troisiemetype/ccboard/Docs/155x32x111 enclosure.jpg

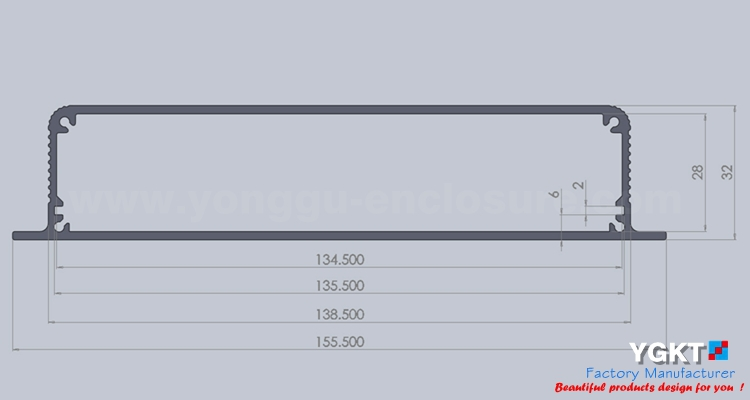
Docs/155x32x111 enclosure.jpg
