troisiemetype/ccboard/Components/BOM.ods

Sheet: ContactConsequencesMono
Id | Designator | Package | Quantity | Designation | Supplier and ref
3 | C1,C5,C8,C9,C10,C11,C12,C15,C16,C17,C18,C22,C23,C24,C25,C31,C32,C33,C38,C39,C41,C43,C50,C51,C52,C53,C6,C47 | C_0603 | 28 | 100n
7 | C13,C14 | C_0603 | 2 | 33p
8 | C19,C26,C34,C49 | CP_Tantalum_Case-A_EIA-3216-18_Reflow | 4 | 10u±
4 | C2,C3 | C_0603 | 2 | 22p
9 | C20,C21,C42,C45,C48 | C_0603 | 5 | 10n
10 | C27,C28 | C_0603 | 2 | 470n
5 | C4,C46 | C_0603 | 2 | 10u
11 | C40,C44 | C_0603 | 2 | 4,7u
6 | C7,C29,C30,C35,C36,C37 | C_0603 | 6 | 1u
12 | D1 | D_1206 | 1 | D
21 | D10 | LED_0603 | 1 | VU_05
22 | D11 | LED_0603 | 1 | VU_06
23 | D12 | LED_0603 | 1 | VU_07
24 | D13 | LED_0603 | 1 | VU_08
25 | D14 | LED_0603 | 1 | VU_09
26 | D15 | LED_0603 | 1 | VU_10
27 | D16 | LED_0603 | 1 | VU_11
28 | D17 | LED_0603 | 1 | VU_12
29 | D18 | LED_0603 | 1 | VU_13
30 | D19 | LED_0603 | 1 | VU_14
13 | D2 | LED_0603 | 1 | LED
31 | D20 | LED_0603 | 1 | VU_15
32 | D21 | LED_0603 | 1 | VU_16
33 | D22 | LED_0603 | 1 | VU_17
34 | D23 | LED_0603 | 1 | VU_18
35 | D24 | LED_0603 | 1 | VU_19
36 | D25 | LED_0603 | 1 | VU_20
37 | D26 | LED_0603 | 1 | VU_21
38 | D27 | LED_0603 | 1 | VU_22
39 | D28 | LED_0603 | 1 | VU_23
40 | D29 | LED_0603 | 1 | VU_24
14 | D3 | D_SOD-123 | 1 | D_Schottky
41 | D30 | LED_0603 | 1 | VU_25
42 | D31 | LED_0603 | 1 | VU_26
43 | D32 | LED_0603 | 1 | VU_27
44 | D33 | LED_0603 | 1 | VU_28
45 | D34 | LED_0603 | 1 | VU_29
46 | D35 | LED_0603 | 1 | VU_30
47 | D36 | LED_0603 | 1 | VU_31
48 | D37 | LED_0603 | 1 | ST_00
49 | D38 | LED_0603 | 1 | ST_01
50 | D39 | LED_0603 | 1 | ST_02
15 | D4 | LED_0603 | 1 | pwr led
51 | D40 | LED_0603 | 1 | ST_03
52 | D41 | LED_0603 | 1 | ST_04
53 | D42 | LED_0603 | 1 | ST_05
16 | D5 | LED_0603 | 1 | VU_00
17 | D6 | LED_0603 | 1 | VU_01
18 | D7 | LED_0603 | 1 | VU_02
19 | D8 | LED_0603 | 1 | VU_03
20 | D9 | LED_0603 | 1 | VU_04
54 | F1 | Fuse_SMD1206_Reflow | 1 | 500mA
55 | F2 | Fuse_SMD1206_Reflow | 1 | 1A
56 | FID1,FID2,FID3 | Fiducial_1mm_Dia_2.54mm_Outer_CopperTop | 3 | Fiducial
107 | IC1 | SOT-5X3 | 1 | TPD2E1B06
57 | IC2,IC6 | SOT-23-5 | 2 | TPS73633
58 | IC3 | SOT-23-5 | 1 | MCP73831/2-OT
59 | IC4 | SOT-23-5 | 1 | TPS73618
60 | IC5 | SOT-23-6 | 1 | MCP1640-SOT
61 | J1 | Pin_Header_Straight_2x03_Pitch2.54mm | 1 | ISP
67 | J10 | Pin_Header_Straight_1x08_Pitch2.54mm | 1 | PWM
68 | J11 | PJ320D_3.5mm_Jack | 1 | Sense1
69 | J12 | PJ320D_3.5mm_Jack | 1 | Sense2
115 | J13 | PJ320D_3.5mm_Jack | 1 | IO1
116 | J14 | PJ320D_3.5mm_Jack | 1 | IO2
70 | J15 | Pin_Header_Straight_1x04_Pitch2.54mm | 1 | I2C
71 | J16 | Pin_Header_Straight_1x04_Pitch2.54mm | 1 | Serial
72 | J17 | Pin_Header_Straight_1x06_Pitch2.54mm | 1 | I2S
62 | J2 | PJ320D_3.5mm_Jack | 1 | Line in
63 | J3 | PJ320D_3.5mm_Jack | 1 | Line out
64 | J4 | SD_Card_Receptacle | 1 | SD_Card
113 | J5 | Pin_Header_Straight_1x01_Pitch2.54mm | 1 | shield
65 | J6 | USB_Micro-B | 1 | USB_OTG
66 | J7 | JST_PH_S2B-PH-SM4-TB_02x2.00mm_Angled | 1 | Battery
2 | J8 | Hirose_FH12-16S-1_SH | 1 | Display - secondary
110 | J9 | Hirose_FH12-16S-1_SH | 1 | Display - main
73 | L1 | L_0603 | 1 | 300
112 | L2 | L_Vishay_IHLP-1616 | 1 | 4,7u
74 | Mount1,Mount2,Mount3,Mount4 | MountingHole_3.2mm_M3 | 4 | Mounting_hole
75 | Q1 | SOT-23 | 1 | Q_PMOS_GSD
76 | R1 | R_0603 | 1 | 330
82 | R10,R11 | R_0603 | 2 | 47k
83 | R12,R13 | R_0603 | 2 | 22k
84 | R14,R15 | R_0603 | 2 | 22
85 | R17 | R_0603 | 1 | 2,2k
86 | R18,R19 | R_0603 | 2 | 20k
77 | R2,R6,R21 | R_0603 | 3 | 10k
114 | R20,R26 | R_0603 | 2 | 0
87 | R22 | R_0603 | 1 | 750
88 | R23 | R_0603 | 1 | 240
89 | R27 | R_0603 | 1 | 1k
90 | R28 | R_0603 | 1 | 24K
78 | R3 | R_0603 | 1 | 5k
79 | R4,R7,R24,R25 | R_0603 | 4 | 100k
80 | R5 | R_0603 | 1 | 1M
81 | R8,R9,R16 | R_0603 | 3 | 470
109 | RN1 | R_Array_Concave_4x0603 | 1 | 500
117 | RN2 | R_Array_Concave_4x0603 | 1 | 1k
91 | RN3,RN4 | R_Array_Concave_4x0603 | 2 | 10k
111 | S1,S2,S3,S4 | Mouse_bites_0.5_6 | 4 | Mouse_bites_0.5_6
92 | SW1 | SW_Tactile_SKHH_Angled | 1 | Reset
93 | SW2 | SW_DIP_x2_W5.08mm_Slide_Copal_CHS-A | 1 | Charge select
98 | SW3 | SW_Tactile_SKHH_Angled | 1 | sw_vol
1 | SW4 | ALPS_EC11B_rotary_encoder | 1 | Rotary_Encoder
99 | SW5 | SW_Tactile_SKHH_Angled | 1 | sw_fadein
95 | SW6 | SW_Tactile_SKHH_Angled | 1 | sw_fadeout
94 | SW7 | SW_Tactile_SKHH_Angled | 1 | sw_touch
96 | SW8 | SW_Tactile_SKHH_Angled | 1 | sw_mode
97 | SW9 | SW_Tactile_SKHH_Angled | 1 | sw_release
100 | U1 | TQFP-44_10x10mm_Pitch0.8mm | 1 | ATMEGA32U4-AU
101 | U2 | LQFP-48_7x7mm_Pitch0.5mm | 1 | vs1053b
108 | U3 | QFN-16-1EP_4x4mm_Pitch0.65mm | 1 | MAX9723-TQFN
102 | U4 | SOIC-24W_7.5x15.4mm_Pitch1.27mm | 1 | MAX7219
103 | U5 | TSSOP-16_4.4x5mm_Pitch0.65mm | 1 | TCA9534
104 | U6 | TSSOP-20_4.4x6.5mm_Pitch0.65mm | 1 | TXS0108EPWR
105 | Y1 | Crystal_SMD_5032-4pin_5.0x3.2mm | 1 | 16MHz
106 | Y2 | Crystal_SMD_5032-4pin_5.0x3.2mm | 1 | 12,288MHz

Sheet: fab v0.1
Designator | value | Footprint | Pins | Quantity | Supplier | ref
C1,C5,C8,C9,C10,C11,C12,C15,C16,C17,C18,C22,C23,C24,C25,C31,C32,C33,C38,C39,C41,C43,C50,C51,C52,C53,C6,C47 | 100n | C_0603 | 2 | 28
C13,C14 | 33p | C_0603 | 2 | 2
C19,C26,C34,C49 | 10u± | CP_Tantalum_Case-A_EIA-3216-18_Reflow | 2 | 4 | Kemet | T491A106K006AT or T491A106M006AT
C2,C3 | 22p | C_0603 | 2 | 2
C20,C21,C42,C45,C48 | 10n | C_0603 | 2 | 5
C27,C28 | 470n | C_0603 | 2 | 2
C4,C46 | 10u | C_0603 | 2 | 2
C40,C44 | 4,7u | C_0603 | 2 | 2
C7,C29,C30,C35,C36,C37 | 1u | C_0603 | 2 | 6
D1 | D | D_1206 | 2 | 1
D2,D5,D6,D7,D8,D9,D10,D11,D12,D13,D14,D15,D16,D17,D18,D19,D20,D21,D22,D23,D24,D25,D26,D27,D28,D29,D30,D31,D32,D33,D34,D35,D36 | red | LED_0603 | 2 | 33
D4,D37,D38,D39,D40,D41,D42 | green | LED_0603 | 2 | 7
D3 | D_Schottky | D_SOD-123 | 2 | 1
F1 | 500mA | Fuse_SMD1206_Reflow | 2 | 1 | Bourns | MF-NSMF050
F2 | 1A | Fuse_SMD1206_Reflow | 2 | 1 | Bourns | MF-NSMF110
IC1 | TPD2E1B06 | SOT-5X3 | 6 | 1 | Texas Instruments | TPD2E1B06
IC2,IC6 | TPS73633 | SOT-23-5 | 5 | 2 | Texas Instruments | TPS73633MDBV
IC3 | MCP73831/2-OT | SOT-23-5 | 5 | 1 | Texas Instruments | CMP73831-2ACI/OT or CMP73831T-2ACI/OT (tape and reel)
IC4 | TPS73618 | SOT-23-5 | 5 | 1 | Texas Instruments | TPS73618MDBV
IC5 | MCP1640-SOT | SOT-23-6 | 6 | 1 | Texas Instruments | MCP1640T-I/MC
J2,J3,J11,J12,J13,J14 | / | PJ320D_3.5mm_Jack | 4 | 6
J4 | SD_Card | SD_Card_Receptacle | 13 | 1 | MPSI | Connex SD, 9 way, push-pull, metal shield, PCB R/A SMT, UL94V-0
J6 | USB_OTG | USB_Micro-B | 7 | 1
J7 | Battery | JST_PH_S2B-PH-SM4-TB_02x2.00mm_Angled | 4 | 1 | JST | S2B-PH-SM4-(xx-)TB
J8,J9 | / | Hirose_FH12-16S-1_SH | 18 | 2 | Hirose (HRS) | FH12-16S-1_SH
L1 | 300 | L_0603 | 2 | 1 | Bourns | MH1608-300Y
L2 | 4,7u | L_Vishay_IHLP-1616 | 2 | 1 | Vishay | IFLS1616AEER100M
Q1 | Q_PMOS_GSD | SOT-23 | 3 | 1 | Fairchild | FDN340P
R1 | 330 | R_0603 | 2 | 1
R10,R11 | 47k | R_0603 | 2 | 2
R12,R13 | 22k | R_0603 | 2 | 2
R14,R15 | 22 | R_0603 | 2 | 2
R17 | 2,2k | R_0603 | 2 | 1
R18,R19 | 20k | R_0603 | 2 | 2
R2,R6,R21 | 10k | R_0603 | 2 | 3
R20,R26 | 0 | R_0603 | 2 | 2
R22 | 750 | R_0603 | 2 | 1
R23 | 240 | R_0603 | 2 | 1
R27 | 1k | R_0603 | 2 | 1
R28 | 24K | R_0603 | 2 | 1
R3 | 5k | R_0603 | 2 | 1
R4,R7,R24,R25 | 100k | R_0603 | 2 | 4
R5 | 1M | R_0603 | 2 | 1
R8,R9,R16 | 470 | R_0603 | 2 | 3
RN1 | 500 | R_Array_Concave_4x0603 | 8 | 1
RN2 | 1k | R_Array_Concave_4x0603 | 8 | 1
RN3,RN4 | 10k | R_Array_Concave_4x0603 | 8 | 2
SW2 | Charge select | SW_DIP_x2_W5.08mm_Slide_Copal_CHS-A | 4 | 1 |  | CHS-02TB1
U1 | ATMEGA32U4-AU | TQFP-44_10x10mm_Pitch0.8mm | 44 | 1 | Atmel | ATmega32U4-AU
U2 | vs1053b | LQFP-48_7x7mm_Pitch0.5mm | 48 | 1 | VLSI | V1053B-L
U3 | MAX9723-TQFN | QFN-16-1EP_4x4mm_Pitch0.65mm | 16 | 1 | Maxim | MAX9723CETE or MAX9723DETE
U4 | MAX7219 | SOIC-24W_7.5x15.4mm_Pitch1.27mm | 24 | 1 | Maxim | MAX7219CWG
U5 | TCA9534 | TSSOP-16_4.4x5mm_Pitch0.65mm | 16 | 1 | Texas Instruments | TCA9534PWR
U6 | TXS0108EPWR | TSSOP-20_4.4x6.5mm_Pitch0.65mm | 20 | 1 | Texas Instruments | TWS0108EPWR
Y1 | 16MHz | Crystal_SMD_5032-4pin_5.0x3.2mm | 4 | 1 | Abracon | ABM3B-16.000MHz-B2
Y2 | 12,288MHz | Crystal_SMD_5032-4pin_5.0x3.2mm | 4 | 1 | Abracon | ABM3B-12.288MHz-B2
/ | / | Total | 346 | 158

Sheet: fab v0.2
Designator | value | Footprint | Pins | Quantity | Supplier | ref
C1,C5,C8,C9,C10,C11,C12,C15,C16,C17,C18,C22,C23,C24,C25,C31,C32,C33,C38,C39,C50,C51,C52,C53,C6,C41,C43,C46 | 100n | C_0603 | 2 | 28
C13,C14 | 33p | C_0603 | 2 | 2
C19,C26,C34,C49 | 10u± | CP_Tantalum_Case-A_EIA-3216-18_Reflow | 2 | 4 | Kemet | T491A106K006AT or T491A106M006AT
C2,C3 | 22p | C_0603 | 2 | 2
C20,C21 | 10n | C_0603 | 2 | 2
C27,C28 | 470n | C_0603 | 2 | 2
C4,C47,C42,C45,C48 | 10u | C_0603 | 2 | 5
C40,C44 | 4,7u | C_0603 | 2 | 2
C7,C29,C30,C35,C36,C37 | 1u | C_0603 | 2 | 6
D1 | D | D_1206 | 2 | 1
D2,D5,D6,D7,D8,D9,D10,D11,D12,D13,D14,D15,D16,D17,D18,D19,D20,D21,D22,D23,D24,D25,D26,D27,D28,D29,D30,D31,D32,D33,D34,D35,D36 | red | LED_0603 | 2 | 33
D3 | D_Schottky | D_SOD-123 | 2 | 1
D4,D37,D38,D39,D40,D41,D42 | green | LED_0603 | 2 | 7
F1 | 500mA | Fuse_SMD1206_Reflow | 2 | 1 | Bourns | MF-NSMF050
F2 | 1A | Fuse_SMD1206_Reflow | 2 | 1 | Bourns | MF-NSMF110
IC1 | TPD2E1B06 | SOT-5X3 | 6 | 1 | Texas Instruments | TPD2E1B06
IC2 | MCP73831/2-OT | SOT-23-5 | 5 | 1 | Texas Instruments | CMP73831-2ACI/OT or CMP73831T-2ACI/OT (tape and reel)
IC3 | MCP1640-SOT | SOT-23-6 | 6 | 1 | Texas Instruments | MCP1640T-I/MC
J2,J3,J11,J12,J13,J14 | / | PJ320D_3.5mm_Jack | 4 | 6
J4 | SD_Card | SD_Card_Receptacle | 13 | 1 | MPSI | Connex SD, 9 way, push-pull, metal shield, PCB R/A SMT, UL94V-0
J6 | USB_OTG | USB_Micro-B | 7 | 1
J7 | Battery | JST_PH_S2B-PH-SM4-TB_02x2.00mm_Angled | 4 | 1 | JST | S2B-PH-SM4-(xx-)TB
J8,J9 | / | Hirose_FH12-16S-1_SH | 18 | 2 | Hirose (HRS) | FH12-16S-1_SH
L1 | 300 | L_0603 | 2 | 1 | Bourns | MH1608-300Y
L2 | 4,7u | L_Vishay_IHLP-1616 | 2 | 1 | Vishay | IFLS1616AEER100M
Q1 | Q_PMOS_GSD | SOT-23 | 3 | 1 | Fairchild | FDN340P
R1 | 330 | R_0603 | 2 | 1
R10,R11 | 47k | R_0603 | 2 | 2
R12,R13 | 22k | R_0603 | 2 | 2
R14,R15 | 22 | R_0603 | 2 | 2
R17 | 2,2k | R_0603 | 2 | 1
R18,R19 | 20k | R_0603 | 2 | 2
R2,R6,R21 | 10k | R_0603 | 2 | 3
R20,R26 | 0 | R_0603 | 2 | 2
R22 | 750 | R_0603 | 2 | 1
R23 | 240 | R_0603 | 2 | 1
R27 | 1k | R_0603 | 2 | 1
R28 | 24K | R_0603 | 2 | 1
R3 | 5k | R_0603 | 2 | 1
R4,R7,R24,R25 | 100k | R_0603 | 2 | 4
R5 | 1M | R_0603 | 2 | 1
R8,R9,R16 | 470 | R_0603 | 2 | 3
RN1 | 500 | R_Array_Concave_4x0603 | 8 | 1
RN2 | 1k | R_Array_Concave_4x0603 | 8 | 1
RN3,RN4 | 10k | R_Array_Concave_4x0603 | 8 | 2
SW2 | Charge select | SW_DIP_x2_W5.08mm_Slide_Copal_CHS-A | 4 | 1 |  | CHS-02TB1
U1 | ATMEGA32U4-AU | TQFP-44_10x10mm_Pitch0.8mm | 44 | 1 | Atmel | ATmega32U4-AU
U2 | vs1053b | LQFP-48_7x7mm_Pitch0.5mm | 48 | 1 | VLSI | V1053B-L
U3 | MAX9723-TQFN | QFN-16-1EP_4x4mm_Pitch0.65mm | 16 | 1 | Maxim | MAX9723CETE or MAX9723DETE
U4,U5 | LD1117S33TR_SOT223 | SOT-223-3_TabPin2 | 4 | 2
U6 | LD1117S18TR_SOT223 | SOT-223-3_TabPin2 | 4 | 1
U7 | MAX7219 | SOIC-24W_7.5x15.4mm_Pitch1.27mm | 24 | 1 | Maxim | MAX7219CWG
U8 | TCA9534 | TSSOP-16_4.4x5mm_Pitch0.65mm | 16 | 1 | Texas Instruments | TCA9534PWR
U9 | TXS0108EPWR | TSSOP-20_4.4x6.5mm_Pitch0.65mm | 20 | 1 | Texas Instruments | TWS0108EPWR
Y1 | 16MHz | Crystal_SMD_5032-4pin_5.0x3.2mm | 4 | 1 | Abracon | ABM3B-16.000MHz-B2
Y2 | 12,288MHz | Crystal_SMD_5032-4pin_5.0x3.2mm | 4 | 1 | Abracon | ABM3B-12.288MHz-B2
/ | / | Total | 344 | 156
