troisiemetype/ccboard/Components/ContactConsequencesMono - components before checking.ods

Sheet: ContactConsequenceMono - fabrication
Id | Comment | Designator | Footprint | Pins | Quantity | Supplier | Ref
2 | 100n | C1,C5,C7,C8,C9,C10,C11,C14,C15,C16,C17,C21,C22,C23,C24,C30,C31,C32,C37,C38,C40,C42,C47,C48 | C_0603 | 2 | 24
6 | 33p | C12,C13 | C_0603 | 2 | 2
7 | 10u± | C18,C25,C33,C46 | CP_Tantalum_Case-A_EIA-3216-18_Reflow | 2 | 4 | Kemet | T491A106K006AT or T491A106M006AT
8 | 10n | C19,C20,C41,C44 | C_0603 | 2 | 4
3 | 22p | C2,C3 | C_0603 | 2 | 2
9 | 470n | C26,C27 | C_0603 | 2 | 2
10 | 4,7u | C39,C43 | C_0603 | 2 | 2
4 | 10u | C4,C45 | C_0603 | 2 | 2
11 | C | C49,C50 | C_0603 | 2 | 2
5 | 1u | C6,C28,C29,C34,C35,C36 | C_0603 | 2 | 6
12 | D | D1 | D_1206 | 2 | 1
14 | red | D2,D5,D6,D7,D8,D9,D10,D11,D12,D13,D14,D15,D16,D17,D18,D19,D20,D21,D22,D23,D24,D25,D26,D27,D28,D29,D30,D31,D32,D33,D34,D35,D36 | LED_0603 | 2 | 33
13 | D_Schottky | D3 | D_SOD-123 | 2 | 1
15 | green | D4,D37,D38,D39,D40,D41,D42 | LED_0603 | 2 | 7
16 | 500mA | F1 | Fuse_SMD1206_Reflow | 2 | 1 | Bourns | MF-NSMF050
17 | 1A | F2 | Fuse_SMD1206_Reflow | 2 | 1 | Bourns | MF-NSMF110
53 | TPD2E1B06 | IC1 | SOT-6 | 6 | 1 | Texas Instruments | TPD2E1B06
18 | TPS73633 | IC2 | SOT-23-5 | 5 | 1 | Texas Instruments | TPS73633MDBV
19 | MCP73831/2-OT | IC3 | SOT-23-5 | 5 | 1 | Texas Instruments | CMP73831-2ACI/OT or CMP73831T-2ACI/OT (tape and reel)
20 | TPS73618 | IC4 | SOT-23-5 | 5 | 1 | Texas Instruments | TPS73618MDBV
21 | MCP1640-SOT | IC5 | SOT-23-6 | 6 | 1 | Texas Instruments | MCP1640T-I/MC
22 | Line in | J2,J3,J11,J12 | PJ320D_3.5mm_Jack | 4 | 4
23 | SD_Card | J4 | SD_Card_Receptacle | 13 | 1 | MPSI | Connex SD, 9 way, push-pull, metal shield, PCB R/A SMT, UL94V-0
24 | USB_OTG | J5 | USB_Micro-B | 7 | 1
25 | Battery | J6 | JST_PH_S2B-PH-SM4-TB_02x2.00mm_Angled | 4 | 1 | JST | S2B-PH-SM4-(xx-)TB
1 | FPC/FFC connector | J7 | Hirose_FH12-16S-1_SH | 18 | 2 | Hirose (HRS) | FH12-16S-1_SH
26 | 30 | L1,L2 | L_0603 | 2 | 2 | Bourns | MH1608-300Y
27 | 4,7u | L3 | L_Vishay_IHLP-1212 | 2 | 1 | Vishay | IFLS1616AEER100M
28 | Q_PMOS_GSD | Q1 | SOT-23 | 3 | 1 | Fairchild | FDN340P
29 | 330 | R1 | R_0603 | 2 | 1
34 | 470 | R10,R11,R18 | R_0603 | 2 | 3
35 | 47k | R12,R13 | R_0603 | 2 | 2
36 | 22k | R14,R15 | R_0603 | 2 | 2
37 | 22 | R16,R17 | R_0603 | 2 | 2
38 | 2,2k | R19 | R_0603 | 2 | 1
30 | 10k | R2,R8,R22 | R_0603 | 2 | 3
39 | 20k | R20,R21 | R_0603 | 2 | 2
40 | 750 | R23 | R_0603 | 2 | 1
41 | 240 | R24 | R_0603 | 2 | 1
42 | 1k | R27,R4,R5 | R_0603 | 2 | 3
43 | 24K | R28 | R_0603 | 2 | 1
31 | 5k | R3 | R_0603 | 2 | 1
32 | 100k | R6,R9,R25,R26 | R_0603 | 2 | 4
33 | 1M | R7 | R_0603 | 2 | 1
55 | 500 | RN1 | R_Array_Concave_4x0603 | 8 | 1
44 | 10k | RN2,RN3 | R_Array_Concave_4x0603 | 8 | 2
45 | Charge select | SW2 | SW_DIP_x2_W5.08mm_Slide_Copal_CHS-A | 4 | 1 |  | CHS-02TB1
46 | ATMEGA32U4-AU | U1 | TQFP-44_10x10mm_Pitch0.8mm | 44 | 1 | Atmel | ATmega32U4-AU
47 | vs1053b | U2 | LQFP-48_7x7mm_Pitch0.5mm | 48 | 1 | VLSI | V1053B-L
54 | MAX9723-TQFN | U3 | QFN-16-1EP_4x4mm_Pitch0.65mm | 16 | 1 | Maxim | MAX9723CETE or MAX9723DETE
48 | MAX7219 | U4 | SOIC-24W_7.5x15.4mm_Pitch1.27mm | 24 | 1 | Maxim | MAX7219CWG
49 | TCA9534 | U5 | TSSOP-16_4.4x5mm_Pitch0.65mm | 16 | 1 | Texas Instruments | TCA9534PWR
50 | TXS0108EPWR | U6 | TSSOP-20_4.4x6.5mm_Pitch0.65mm | 20 | 1 | Texas Instruments | TWS0108EPWR
51 | 16MHz | Y1 | Crystal_SMD_5032-4pin_5.0x3.2mm | 4 | 1 | Abracon | ABM3B-16.000MHz-B2
52 | 12,288MHz | Y2 | Crystal_SMD_5032-4pin_5.0x3.2mm | 4 | 1 | Abracon | ABM3B-12.288MHz-B2
 |  |  |  | 338 | 152

Sheet: ContactConsequencesMono - Full
Id | Comment | Designator | Footprint | Pins | Quantity | Supplier | Ref | To be mounted
1 | Rotary_Encoder | SW4 | ALPS_EC11B_rotary_encoder, without switch | 5 | 1 | ALPS | EC11B15202AN | n
2 | FPC/FFC connector | J7 | Hirose_FH12-16S-1_SH | 18 | 2 | Hirose (HRS) | FH12-16S-1_SH
3 | 100n | C1,C5,C7,C8,C9,C10,C11,C14,C15,C16,C17,C21,C22,C23,C24,C30,C31,C32,C37,C38,C40,C42,C47,C48 | C_0603 | 2 | 24
4 | 22p | C2,C3 | C_0603 | 2 | 2
5 | 10u | C4,C45 | C_0603 | 2 | 2
6 | 1u | C6,C28,C29,C34,C35,C36 | C_0603 | 2 | 6
7 | 33p | C12,C13 | C_0603 | 2 | 2
8 | 10u± | C18,C25,C33,C46 | CP_Tantalum_Case-A_EIA-3216-18_Reflow | 2 | 4 | Kemet | T491A106K006AT or T491A106M006AT
9 | 10n | C19,C20,C41,C44 | C_0603 | 2 | 4
10 | 470n | C26,C27 | C_0603 | 2 | 2
11 | 4,7u | C39,C43 | C_0603 | 2 | 2
12 | C | C49,C50 | C_0603 | 2 | 2
13 | D | D1 | D_1206 | 2 | 1
14 | D_Schottky | D3 | D_SOD-123 | 2 | 1
15 | red | D2,D5,D6,D7,D8,D9,D10,D11,D12,D13,D14,D15,D16,D17,D18,D19,D20,D21,D22,D23,D24,D25,D26,D27,D28,D29,D30,D31,D32,D33,D34,D35,D36 | LED_0603 | 2 | 33
16 | green | D4,D37,D38,D39,D40,D41,D42 | LED_0603 | 2 | 7
17 | 500mA | F1 | Fuse_SMD1206_Reflow | 2 | 1 | Bourns | MF-NSMF050
18 | 1A | F2 | Fuse_SMD1206_Reflow | 2 | 1 | Bourns | MF-NSMF110
19 | Fiducial | FID1,FID2,FID3 | Fiducial_1mm_Dia_2.54mm_Outer_CopperTop | 0 | 3 |  |  | n
20 | TPS73633 | IC2 | SOT-23-5 | 5 | 1 | Texas Instruments | TPS73633MDBV
21 | MCP73831/2-OT | IC3 | SOT-23-5 | 5 | 1 | Texas Instruments | CMP73831-2ACI/OT or CMP73831T-2ACI/OT (tape and reel)
22 | TPS73618 | IC4 | SOT-23-5 | 5 | 1 | Texas Instruments | TPS73618MDBV
23 | MCP1640-SOT | IC5 | SOT-23-6 | 6 | 1 | Texas Instruments | MCP1640T-I/MC
24 | ISP | J1 | Pin_Header_Straight_2x03_Pitch2.54mm | 6 | 1 |  |  | n
25 | Line in | J2,J3,J11,J12 | PJ320D_3.5mm_Jack | 4 | 4
26 | SD_Card | J4 | SD_Card_Receptacle | 13 | 1 | MPSI | Connex SD, 9 way, push-pull, metal shield, PCB R/A SMT, UL94V-0
27 | USB_OTG | J5 | USB_Micro-B | 7 | 1
28 | Battery | J6 | JST_PH_S2B-PH-SM4-TB_02x2.00mm_Angled | 4 | 1 | JST | S2B-PH-SM4-(xx-)TB
29 | PWM | J9 | Pin_Header_Straight_1x08_Pitch2.54mm | 8 | 1 |  |  | n
30 | IO | J10 | Pin_Header_Straight_1x04_Pitch2.54mm | 4 | 1 |  |  | n
31 | I2C | J13 | Pin_Header_Straight_1x04_Pitch2.54mm | 4 | 1 |  |  | n
32 | Serial | J14 | Pin_Header_Straight_1x04_Pitch2.54mm | 4 | 1 |  |  | n
33 | I2S | J15 | Pin_Header_Straight_1x06_Pitch2.54mm | 6 | 1 |  |  | n
34 | 30 | L1,L2 | L_0603 | 2 | 2 | Bourns | MH1608-300Y
35 | 4,7u | L3 | L_Vishay_IHLP-1212 | 2 | 1 | Vishay | IFLS1616AEER100M
36 | Mounting_hole | Mount1,Mount2,Mount3,Mount4 | MountingHole_3.2mm_M3 | 0 | 4 |  |  | n
37 | Q_PMOS_GSD | Q1 | SOT-23 | 3 | 1 | Fairchild | FDN340P
38 | 330 | R1 | R_0603 | 2 | 1
39 | 10k | R2,R8,R22 | R_0603 | 2 | 3
40 | 5k | R3 | R_0603 | 2 | 1
41 | 100k | R6,R9,R25,R26 | R_0603 | 2 | 4
42 | 1M | R7 | R_0603 | 2 | 1
43 | 470 | R10,R11,R18 | R_0603 | 2 | 3
44 | 47k | R12,R13 | R_0603 | 2 | 2
45 | 22k | R14,R15 | R_0603 | 2 | 2
46 | 22 | R16,R17 | R_0603 | 2 | 2
47 | 2,2k | R19 | R_0603 | 2 | 1
48 | 20k | R20,R21 | R_0603 | 2 | 2
49 | 750 | R23 | R_0603 | 2 | 1
50 | 240 | R24 | R_0603 | 2 | 1
51 | 1k | R27,R4,R5 | R_0603 | 2 | 3
52 | 24K | R28 | R_0603 | 2 | 1
53 | 10k | RN2,RN3 | R_Array_Concave_4x0603 | 8 | 2
54 | Reset | SW1 | SW_Tactile_SKHH_Angled | 4 | 1 | ALPS | SKHHLMA010 | n
55 | Charge select | SW2 | SW_DIP_x2_W5.08mm_Slide_Copal_CHS-A | 4 | 1 |  | CHS-02TB1
56 | sw_touch | SW7 | SW_Tactile_SKHH_Angled | 4 | 1 | ALPS | SKHHLUA010 | n
57 | sw_fadeout | SW6 | SW_Tactile_SKHH_Angled | 4 | 1 | ALPS | SKHHLUA010 | n
58 | sw_mode | SW8 | SW_Tactile_SKHH_Angled | 4 | 1 | ALPS | SKHHLUA010 | n
59 | sw_release | SW9 | SW_Tactile_SKHH_Angled | 4 | 1 | ALPS | SKHHLUA010 | n
60 | sw_vol | SW3 | SW_Tactile_SKHH_Angled | 4 | 1 | ALPS | SKHHLUA010 | n
61 | sw_fadein | SW5 | SW_Tactile_SKHH_Angled | 4 | 1 | ALPS | SKHHLUA010 | n
62 | ATMEGA32U4-AU | U1 | TQFP-44_10x10mm_Pitch0.8mm | 44 | 1 | Atmel | ATmega32U4-AU
63 | vs1053b | U2 | LQFP-48_7x7mm_Pitch0.5mm | 48 | 1 | VLSI | V1053B-L
64 | MAX7219 | U4 | SOIC-24W_7.5x15.4mm_Pitch1.27mm | 24 | 1 | Maxim | MAX7219CWG
65 | TCA9534 | U5 | TSSOP-16_4.4x5mm_Pitch0.65mm | 16 | 1 | Texas Instruments | TCA9534PWR
66 | TXS0108EPWR | U6 | TSSOP-20_4.4x6.5mm_Pitch0.65mm | 20 | 1 | Texas Instruments | TWS0108EPWR
67 | 16MHz | Y1 | Crystal_SMD_5032-4pin_5.0x3.2mm | 4 | 1 | Abracon | ABM3B-16.000MHz-B2
68 | 12,288MHz | Y2 | Crystal_SMD_5032-4pin_5.0x3.2mm | 4 | 1 | Abracon | ABM3B-12.288MHz-B2
69 | TPD2E1B06 | IC1 | SOT-6 | 6 | 1 | Texas Instruments | TPD2E1B06
70 | MAX9723-TQFN | U3 | QFN-16-1EP_4x4mm_Pitch0.65mm | 16 | 1 | Maxim | MAX9723CETE or MAX9723DETE
71 | 500 | RN1 | R_Array_Concave_4x0603 | 8 | 1
72 | Mouse_bites_0.5_6 | S1,S2,S3,S4 | Mouse_bites_0.5_6 | 0 | 4 |  |  | n
 |  |  |  | 398 | 172
