troisiemetype/ccboard/PDF/Face avant 155x22.pdf

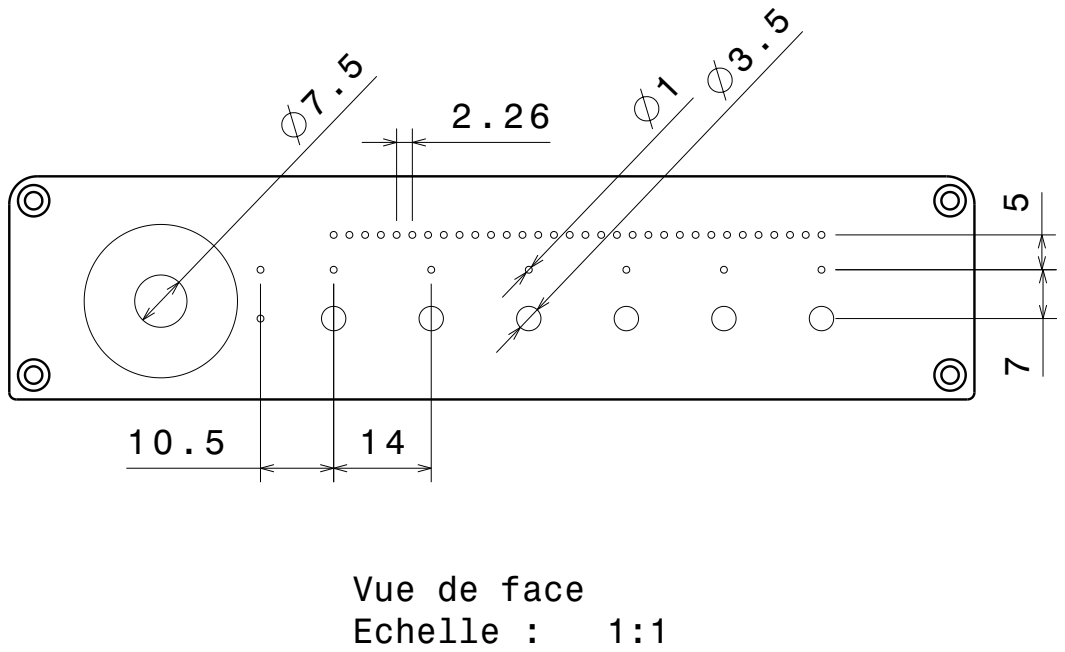
[picture p2: page 1]
Echelle :

Vue de face
