troisiemetype/ccboard/ContactConsequencesMono.kicad_pcb

## KiCad design ContactConsequencesMono.kicad_pcb (2017-11-15)

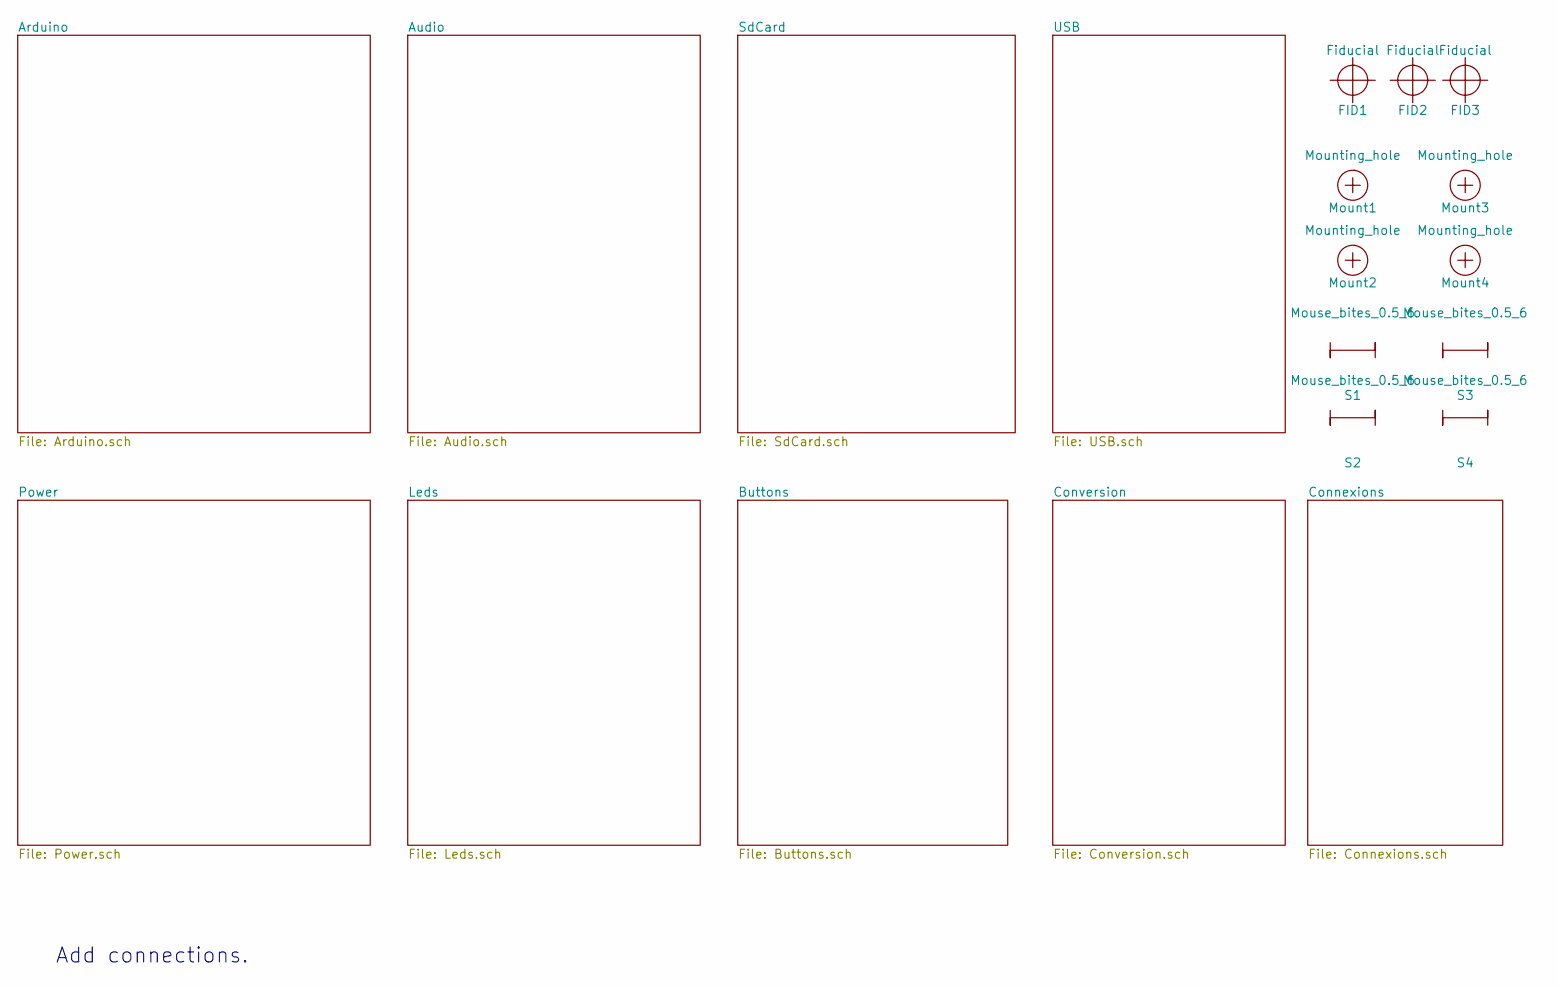
[picture p3: schematic ContactConsequencesMono.sch]

Parts:
FID1, FID2, FID3: Fiducial; Fiducial_1mm_Dia_2.54mm_Outer_CopperTop
Mount1, Mount2, Mount3, Mount4: Mounting_hole; MountingHole_3.2mm_M3
S1, S2, S3, S4: Mouse_bites_0.5_6

Notes on the sheet:
Add connections.

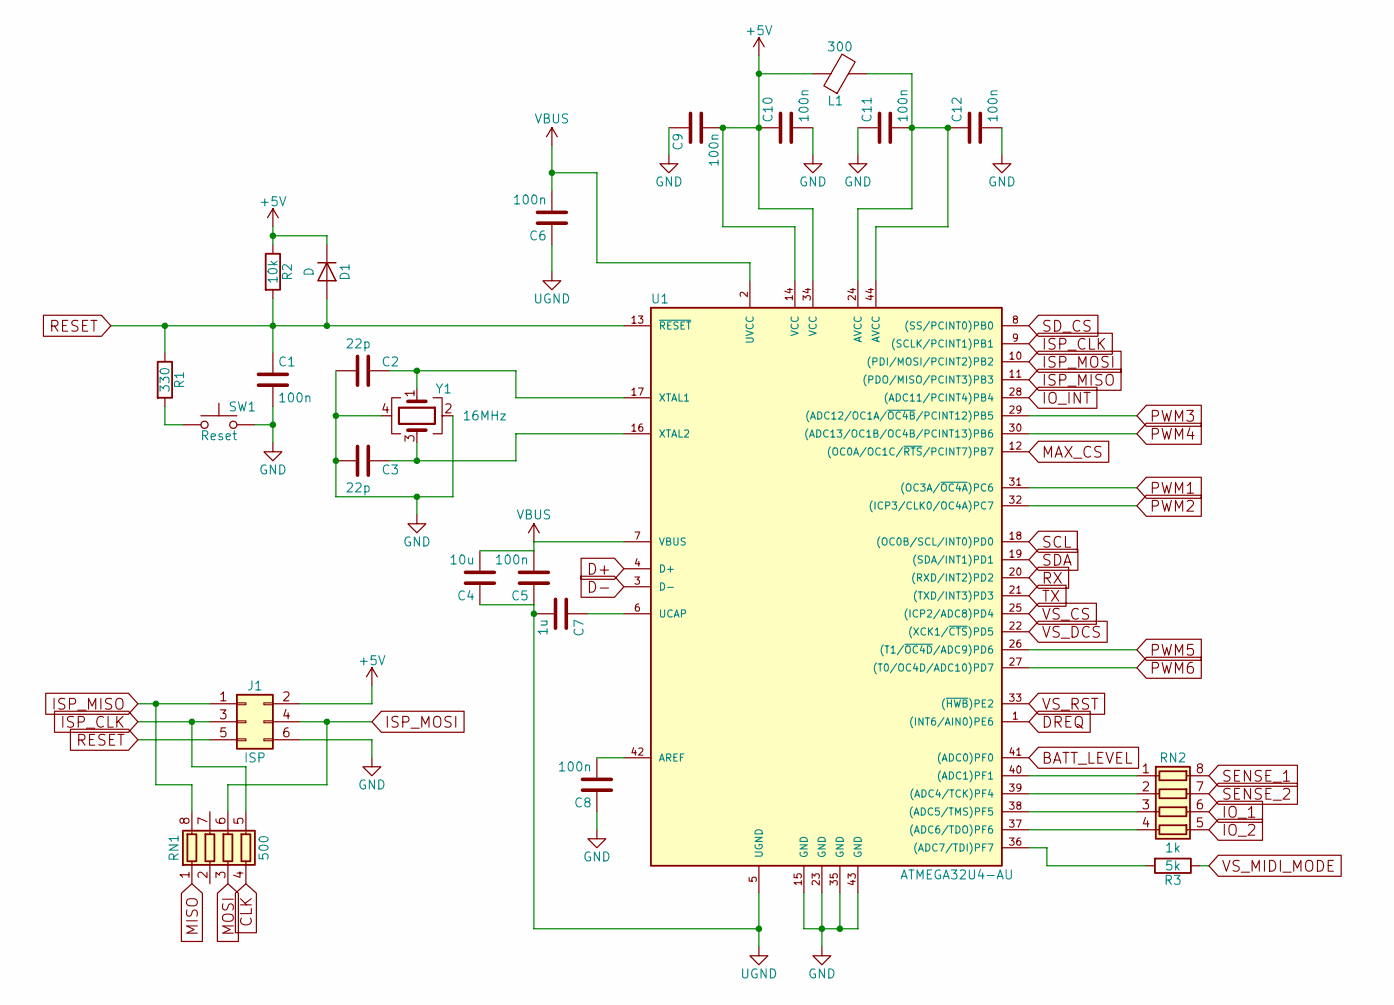
[picture p4: schematic Arduino.sch]

Parts:
C1, C5, C6, C8, C9, C10, C11, C12: 100n; C_0603
C2, C3: 22p; C_0603
C4: 10u; C_0603
C7: 1u; C_0603
D1: D; D_1206
J1: ISP; Pin_Header_Straight_2x03_Pitch2.54mm
L1: 300; L_0603
R1: 330; R_0603
R2: 10k; R_0603
R3: 5k; R_0603
RN1: 500; R_Array_Concave_4x0603
RN2: 1k; R_Array_Concave_4x0603
SW1: Reset; SW_Tactile_SKHH_Angled
U1: ATMEGA32U4-AU; TQFP-44_10x10mm_Pitch0.8mm
Y1: 16MHz; Crystal_SMD_5032-4pin_5.0x3.2mm

Connections:
+5V: C9.2, C10.1, D1.1 (K), J1.2, L1.1, R2.1, U1.14 (VCC), U1.34 (VCC); also elsewhere on the board
BATT_LEVEL: U1.41 ((ADC0)PF0); also elsewhere on the board
CLK: RN1.4 (R4.1); also elsewhere on the board
D+: U1.4 (D+); also elsewhere on the board
D-: U1.3 (D-); also elsewhere on the board
DGND: C1.2, C2.2, C3.2, C8.1, C9.1, C10.2, C11.1, C12.2, J1.6, SW1.2, U1.15 (GND), U1.23 (GND), U1.35 (GND), U1.43 (GND), Y1.2, Y1.4; also elsewhere on the board
DREQ: U1.1 ((INT6/AIN0)PE6); also elsewhere on the board
IO_1: RN2.6 (R3.2); also elsewhere on the board
IO_2: RN2.5 (R4.2); also elsewhere on the board
IO_INT: U1.28 ((ADC11/PCINT4)PB4); also elsewhere on the board
ISP_CLK: J1.3, RN1.5 (R4.2), U1.9 ((SCLK/PCINT1)PB1)
ISP_MISO: J1.1, RN1.8 (R1.2), U1.11 ((PDO/MISO/PCINT3)PB3)
ISP_MOSI: J1.4, RN1.6 (R3.2), U1.10 ((PDI/MOSI/PCINT2)PB2)
MAX_CS: U1.12 ((OC0A/OC1C/~RTS~/PCINT7)PB7); also elsewhere on the board
MISO: RN1.1 (R1.1); also elsewhere on the board
MOSI: RN1.3 (R3.1); also elsewhere on the board
unnamed: C2.1, U1.17 (XTAL1), Y1.1
unnamed: C3.1, U1.16 (XTAL2), Y1.3
unnamed: C7.1, U1.6 (UCAP)
unnamed: C8.2, U1.42 (AREF)
unnamed: C11.2, C12.1, L1.2, U1.24 (AVCC), U1.44 (AVCC)
unnamed: R1.2, SW1.1
unnamed: R3.2, U1.36 ((ADC7/TDI)PF7)
unnamed: RN2.1 (R1.1), U1.40 ((ADC1)PF1)
unnamed: RN2.2 (R2.1), U1.39 ((ADC4/TCK)PF4)
unnamed: RN2.3 (R3.1), U1.38 ((ADC5/TMS)PF5)
unnamed: RN2.4 (R4.1), U1.37 ((ADC6/TDO)PF6)
PWM1: U1.31 ((OC3A/~OC4A~)PC6); also elsewhere on the board
PWM2: U1.32 ((ICP3/CLK0/OC4A)PC7); also elsewhere on the board
PWM3: U1.29 ((ADC12/OC1A/~OC4B~/PCINT12)PB5); also elsewhere on the board
PWM4: U1.30 ((ADC13/OC1B/OC4B/PCINT13)PB6); also elsewhere on the board
PWM5: U1.26 ((T1/~OC4D~/ADC9)PD6); also elsewhere on the board
PWM6: U1.27 ((T0/OC4D/ADC10)PD7); also elsewhere on the board
RESET: C1.1, D1.2 (A), J1.5, R1.1, R2.2, U1.13 (~RESET~)
RX: U1.20 ((RXD/INT2)PD2); also elsewhere on the board
SCL: U1.18 ((OC0B/SCL/INT0)PD0); also elsewhere on the board
SDA: U1.19 ((SDA/INT1)PD1); also elsewhere on the board
SD_CS: U1.8 ((SS/PCINT0)PB0); also elsewhere on the board
SENSE_1: RN2.8 (R1.2); also elsewhere on the board
SENSE_2: RN2.7 (R2.2); also elsewhere on the board
TX: U1.21 ((TXD/INT3)PD3); also elsewhere on the board
UGND: C4.1, C5.1, C6.1, C7.2, U1.5 (UGND); also elsewhere on the board
VBUS: C4.2, C5.2, C6.2, U1.2 (UVCC), U1.7 (VBUS); also elsewhere on the board
VS_CS: U1.25 ((ICP2/ADC8)PD4); also elsewhere on the board
VS_DCS: U1.22 ((XCK1/~CTS~)PD5); also elsewhere on the board
VS_MIDI_MODE: R3.1; also elsewhere on the board
VS_RST: U1.33 ((~HWB~)PE2); also elsewhere on the board

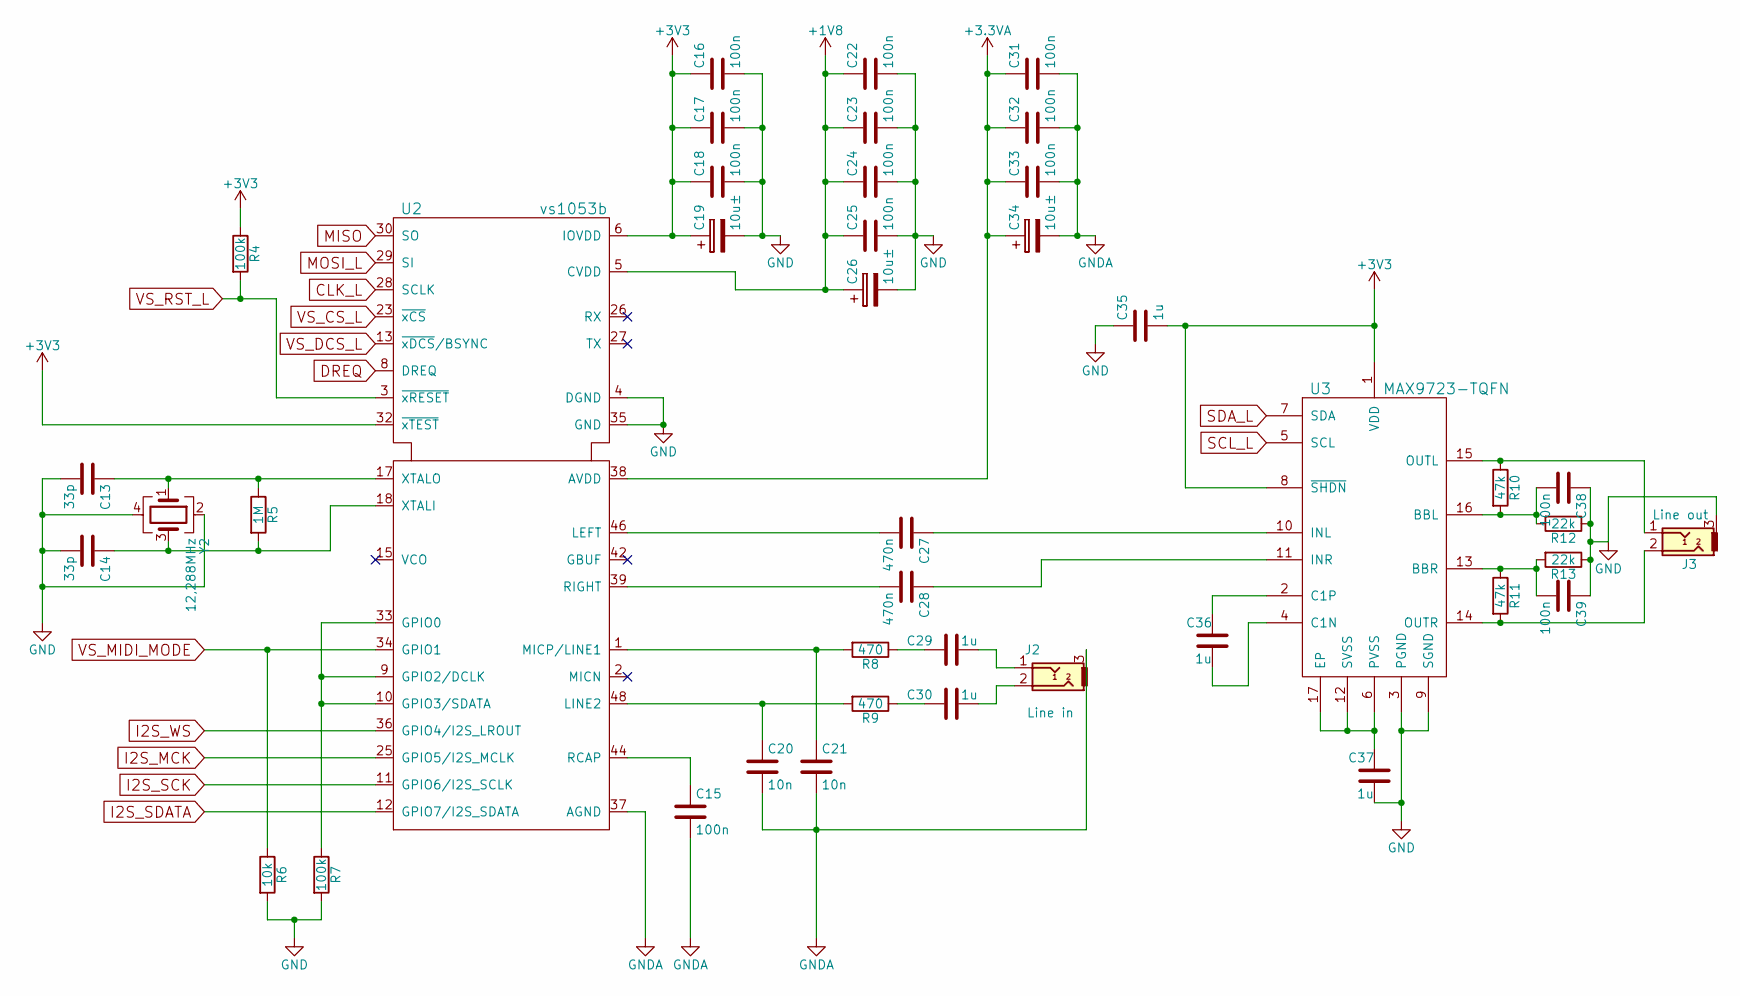
[picture p5: schematic Audio.sch]

Parts:
C13, C14: 33p; C_0603
C15, C16, C17, C18, C22, C23, C24, C25, C31, C32, C33, C38, C39: 100n; C_0603
C19, C26, C34: 10u±; CP_Tantalum_Case-A_EIA-3216-18_Reflow
C20, C21: 10n; C_0603
C27, C28: 470n; C_0603
C29, C30, C35, C36, C37: 1u; C_0603
J2: Line in; PJ320D_3.5mm_Jack
J3: Line out; PJ320D_3.5mm_Jack
R4, R7: 100k; R_0603
R5: 1M; R_0603
R6: 10k; R_0603
R8, R9: 470; R_0603
R10, R11: 47k; R_0603
R12, R13: 22k; R_0603
U2: vs1053b; LQFP-48_7x7mm_Pitch0.5mm
U3: MAX9723-TQFN; QFN-16-1EP_4x4mm_Pitch0.65mm
Y2: 12,288MHz; Crystal_SMD_5032-4pin_5.0x3.2mm

Connections:
+1V8: C22.1, C23.1, C24.1, C25.1, C26.1, U2.5 (CVDD), U2.7 (CVDD), U2.24 (CVDD), U2.31 (CVDD); also elsewhere on the board
+3.3VA: C31.1, C32.1, C33.1, C34.1, U2.38 (AVDD), U2.43 (AVDD), U2.45 (AVDD); also elsewhere on the board
AGND: C15.2, C20.2, C21.2, C31.2, C32.2, C33.2, C34.2, J2.3, U2.37 (AGND), U2.40 (AGND), U2.41 (AGND), U2.47 (AGND); also elsewhere on the board
CLK_L: U2.28 (SCLK); also elsewhere on the board
DGND: C13.2, C14.2, C16.2, C17.2, C18.2, C19.2, C22.2, C23.2, C24.2, C25.2, C26.2, C35.1, C37.2, C38.1, C39.1, J3.3, R6.2, R7.2, R12.1, R13.1, U2.4 (DGND), U2.16 (DGND), U2.20 (DGND), U2.21 (DGND), U2.22 (DGND), U2.35 (GND), U3.3 (PGND), U3.9 (SGND), Y2.2, Y2.4; also elsewhere on the board
DREQ: U2.8 (DREQ); also elsewhere on the board
I2S_MCK: U2.25 (GPIO5/I2S_MCLK); also elsewhere on the board
I2S_SCK: U2.11 (GPIO6/I2S_SCLK); also elsewhere on the board
I2S_SDATA: U2.12 (GPIO7/I2S_SDATA); also elsewhere on the board
I2S_WS: U2.36 (GPIO4/I2S_LROUT); also elsewhere on the board
MISO: U2.30 (SO); also elsewhere on the board
MOSI_L: U2.29 (SI); also elsewhere on the board
unnamed: C13.1, R5.1, U2.17 (XTALO), Y2.1
unnamed: C14.1, R5.2, U2.18 (XTALI), Y2.3
unnamed: C15.1, U2.44 (RCAP)
unnamed: C20.1, R9.2, U2.48 (LINE2)
unnamed: C21.1, R8.2, U2.1 (MICP/LINE1)
unnamed: C27.1, U3.10 (INL)
unnamed: C27.2, U2.46 (LEFT)
unnamed: C28.1, U3.11 (INR)
unnamed: C28.2, U2.39 (RIGHT)
unnamed: C29.1, R8.1
unnamed: C29.2, J2.1
unnamed: C30.1, R9.1
unnamed: C30.2, J2.2
unnamed: C36.1, U3.2 (C1P)
unnamed: C36.2, U3.4 (C1N)
unnamed: C37.1, U3.6 (PVSS), U3.12 (SVSS), U3.17 (EP)
unnamed: C38.2, R10.2, R12.2, U3.16 (BBL)
unnamed: C39.2, R11.1, R13.2, U3.13 (BBR)
unnamed: J3.1, R10.1, U3.15 (OUTL)
unnamed: J3.2, R11.2, U3.14 (OUTR)
unnamed: R7.1, U2.9 (GPIO2/DCLK), U2.10 (GPIO3/SDATA), U2.33 (GPIO0)
SCL_L: U3.5 (SCL); also elsewhere on the board
SDA_L: U3.7 (SDA); also elsewhere on the board
VS_CS_L: U2.23 (~xCS); also elsewhere on the board
VS_DCS_L: U2.13 (~xDCS~/BSYNC); also elsewhere on the board
VS_MIDI_MODE: R6.1, U2.34 (GPIO1); also elsewhere on the board
VS_RST_L: R4.2, U2.3 (~xRESET); also elsewhere on the board

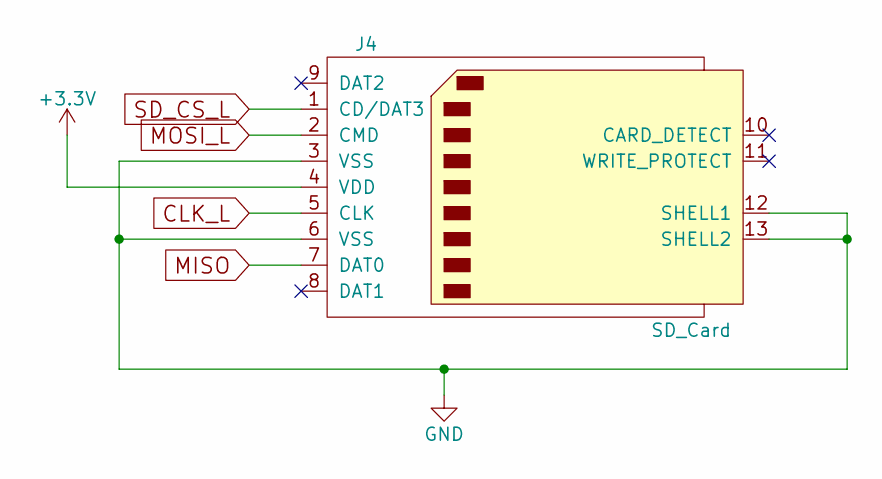
[picture p6: schematic SdCard.sch]

Parts:
J4: SD_Card; SD_Card_Receptacle

Connections:
CLK_L: J4.5 (CLK); also elsewhere on the board
DGND: J4.3 (VSS), J4.6 (VSS), J4.12 (SHELL1), J4.13 (SHELL2); also elsewhere on the board
MISO: J4.7 (DAT0); also elsewhere on the board
MOSI_L: J4.2 (CMD); also elsewhere on the board
SD_CS_L: J4.1 (CD/DAT3); also elsewhere on the board

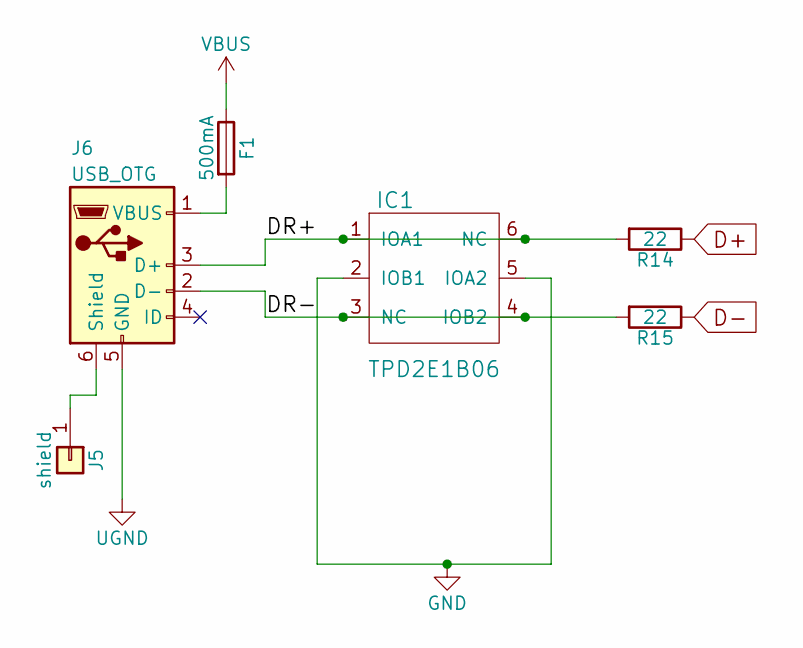
[picture p7: schematic USB.sch]

Parts:
F1: 500mA; Fuse_SMD1206_Reflow
IC1: TPD2E1B06; SOT-5X3
J5: shield; Pin_Header_Straight_1x01_Pitch2.54mm
J6: USB_OTG; USB_Micro-B
R14, R15: 22; R_0603

Connections:
/USB/DR+: IC1.1 (IOA1), IC1.6 (NC), J6.3 (D+), R14.2
/USB/DR-: IC1.3 (NC), IC1.4 (IOB2), J6.2 (D-), R15.2
D+: R14.1; also elsewhere on the board
D-: R15.1; also elsewhere on the board
DGND: IC1.2 (IOB1), IC1.5 (IOA2); also elsewhere on the board
unnamed: F1.2, J6.1 (VBUS)
unnamed: J5.1, J6.6 (Shield)
UGND: J6.5 (GND); also elsewhere on the board
VBUS: F1.1; also elsewhere on the board

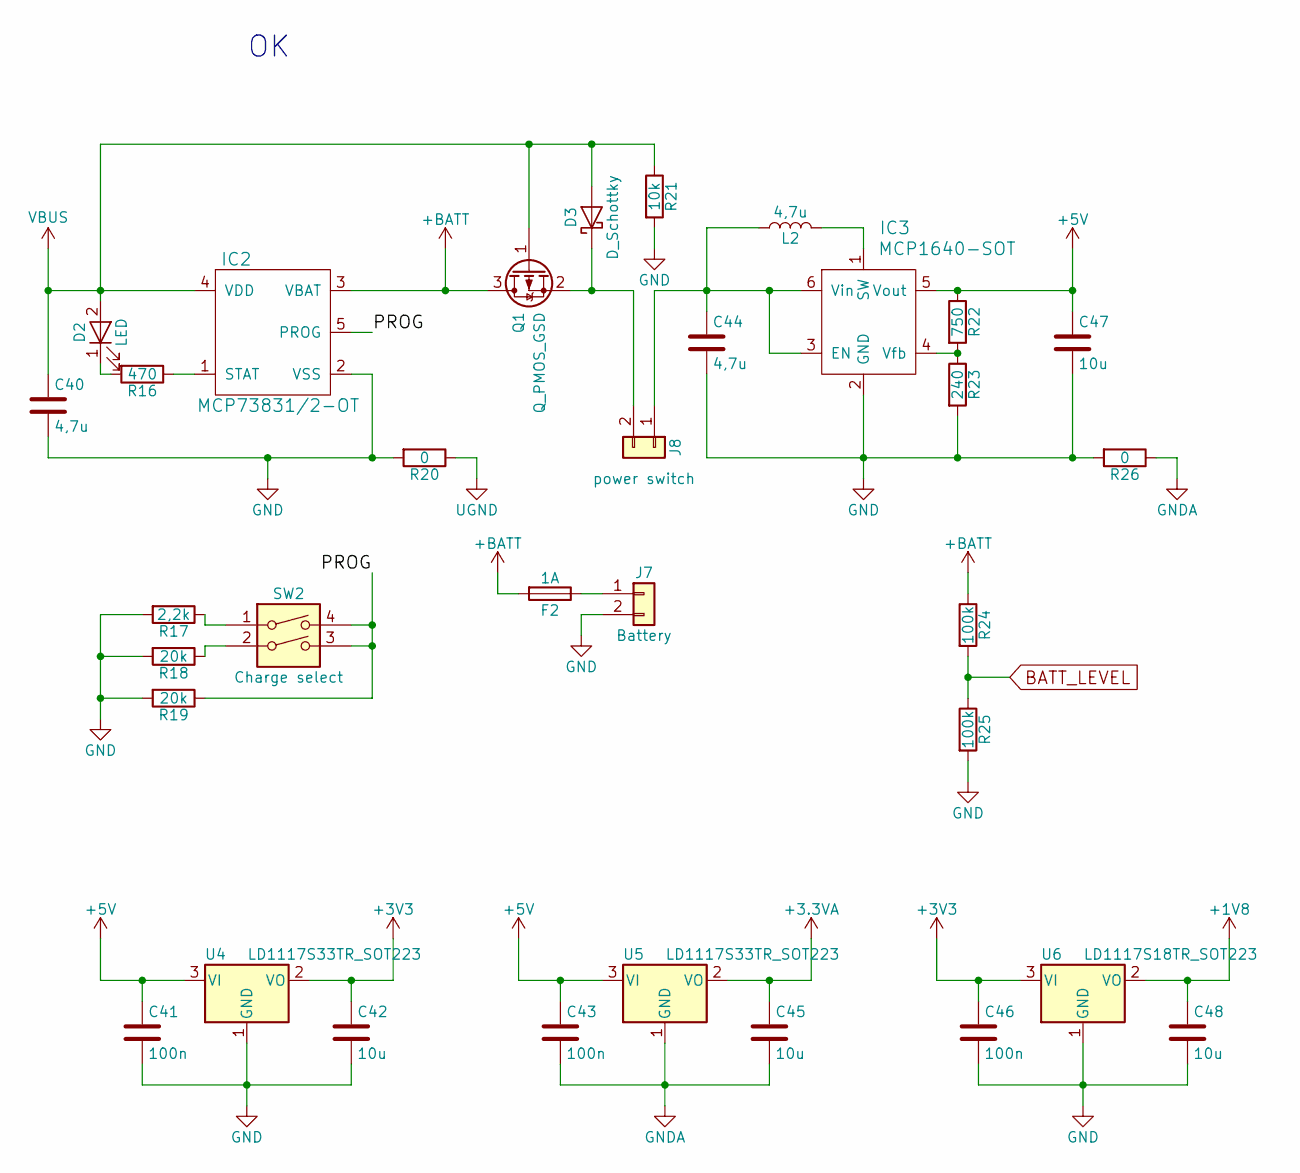
[picture p8: schematic Power.sch]

Parts:
C40, C44: 4,7u; C_0603
C41, C43, C46: 100n; C_0603
C42, C45, C47, C48: 10u; C_0603
D2: LED; LED_0603
D3: D_Schottky; D_SOD-123
F2: 1A; Fuse_SMD1206_Reflow
IC2: MCP73831/2-OT; SOT-23-5
IC3: MCP1640-SOT; SOT-23-6
J7: Battery; JST_PH_S2B-PH-SM4-TB_02x2.00mm_Angled
J8: power switch; Pin_Header_Straight_1x02_Pitch2.54mm
L2: 4,7u; L_Vishay_IHLP-1616
Q1: Q_PMOS_GSD; SOT-23
R16: 470; R_0603
R17: 2,2k; R_0603
R18, R19: 20k; R_0603
R20, R26: 0; R_0603
R21: 10k; R_0603
R22: 750; R_0603
R23: 240; R_0603
R24, R25: 100k; R_0603
SW2: Charge select; SW_DIP_x2_W5.08mm_Slide_Copal_CHS-A
U4, U5: LD1117S33TR_SOT223; SOT-223-3_TabPin2
U6: LD1117S18TR_SOT223; SOT-223-3_TabPin2

Connections:
+1V8: C48.1, U6.2 (VO); also elsewhere on the board
+3.3VA: C45.1, U5.2 (VO); also elsewhere on the board
+5V: C41.1, C43.1, C47.1, IC3.5 (Vout), R22.1, U4.3 (VI), U5.3 (VI); also elsewhere on the board
+BATT: F2.2, IC2.3 (VBAT), Q1.3 (D), R24.1
/Power/PROG: IC2.5 (PROG), R19.1, SW2.3, SW2.4
AGND: C43.2, C45.2, R26.1, U5.1 (GND); also elsewhere on the board
BATT_LEVEL: R24.2, R25.1; also elsewhere on the board
DGND: C40.2, C41.2, C42.2, C44.2, C46.2, C47.2, C48.2, IC2.2 (VSS), IC3.2 (GND), J7.2, R17.2, R18.2, R19.2, R20.2, R21.2, R23.2, R25.2, R26.2, U4.1 (GND), U6.1 (GND); also elsewhere on the board
unnamed: C44.1, IC3.3 (EN), IC3.6 (Vin), J8.1, L2.1
unnamed: D2.1 (K), R16.2
unnamed: D3.1 (K), J8.2, Q1.2 (S)
unnamed: F2.1, J7.1
unnamed: IC2.1 (STAT), R16.1
unnamed: IC3.1 (SW), L2.2
unnamed: IC3.4 (Vfb), R22.2, R23.1
unnamed: R17.1, SW2.1
unnamed: R18.1, SW2.2
UGND: R20.1; also elsewhere on the board
VBUS: C40.1, D2.2 (A), D3.2 (A), IC2.4 (VDD), Q1.1 (G), R21.1; also elsewhere on the board

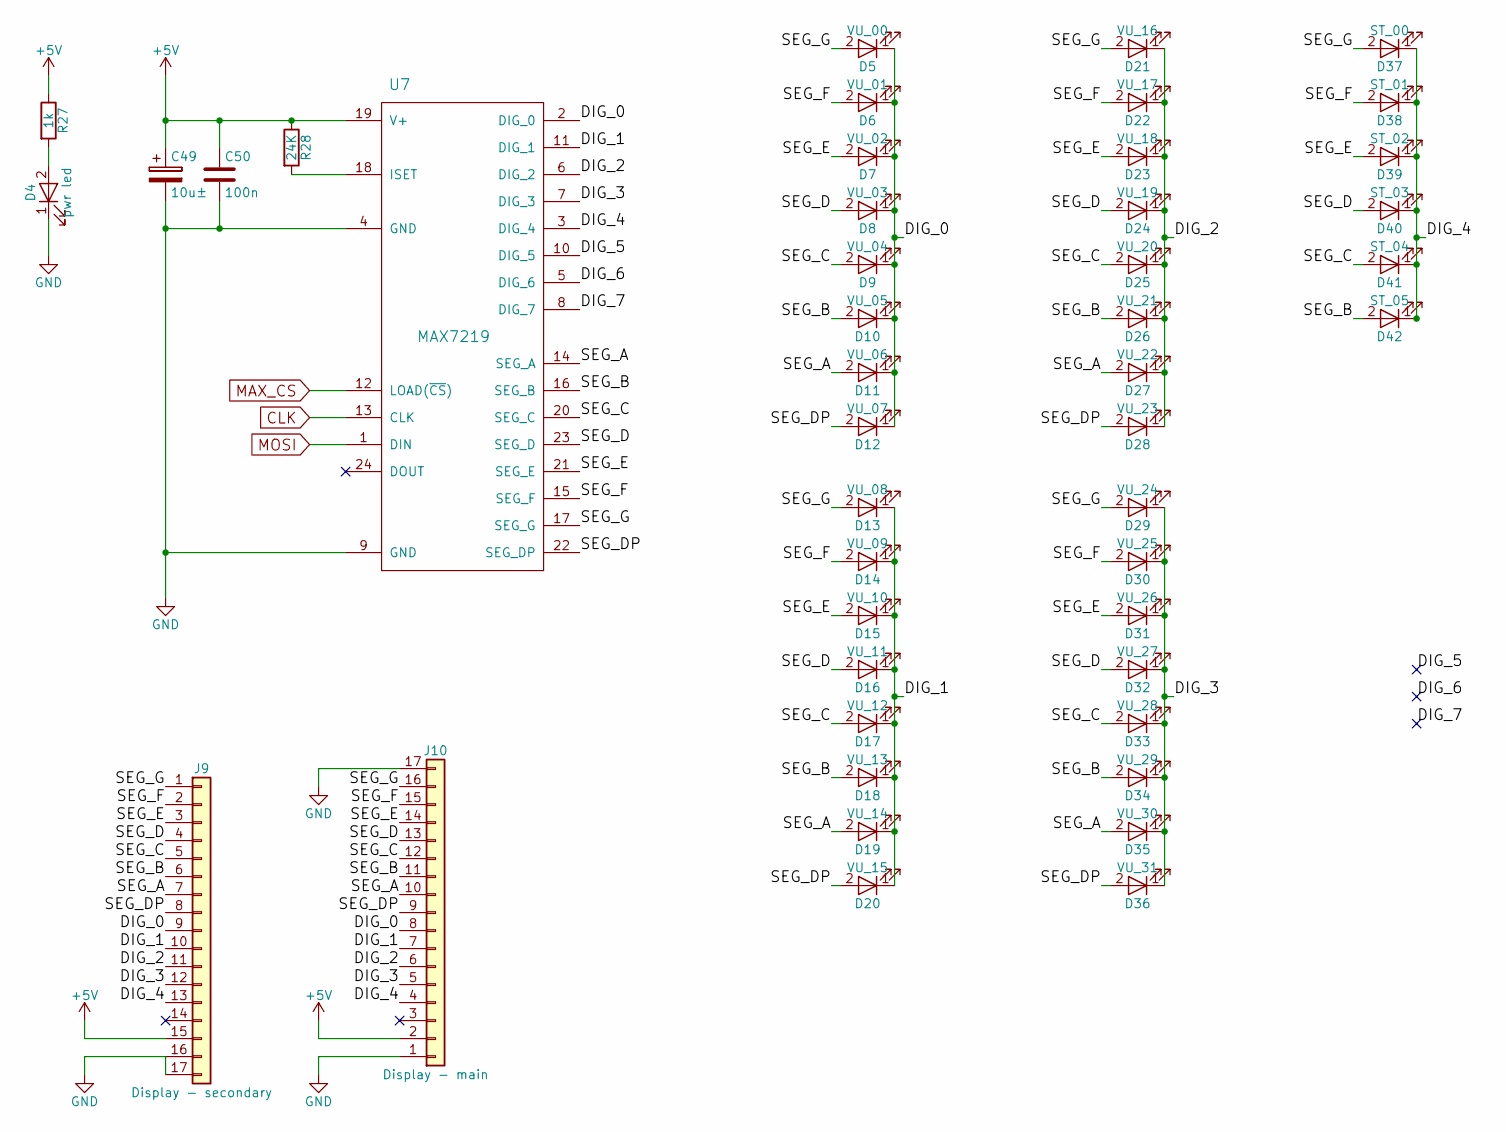
[picture p9: schematic Leds.sch]

Parts:
C49: 10u±; CP_Tantalum_Case-A_EIA-3216-18_Reflow
C50: 100n; C_0603
D4: pwr led; LED_0603
D5: VU_00; LED_0603
D6: VU_01; LED_0603
D7: VU_02; LED_0603
D8: VU_03; LED_0603
D9: VU_04; LED_0603
D10: VU_05; LED_0603
D11: VU_06; LED_0603
D12: VU_07; LED_0603
D13: VU_08; LED_0603
D14: VU_09; LED_0603
D15: VU_10; LED_0603
D16: VU_11; LED_0603
D17: VU_12; LED_0603
D18: VU_13; LED_0603
D19: VU_14; LED_0603
D20: VU_15; LED_0603
D21: VU_16; LED_0603
D22: VU_17; LED_0603
D23: VU_18; LED_0603
D24: VU_19; LED_0603
D25: VU_20; LED_0603
D26: VU_21; LED_0603
D27: VU_22; LED_0603
D28: VU_23; LED_0603
D29: VU_24; LED_0603
D30: VU_25; LED_0603
D31: VU_26; LED_0603
D32: VU_27; LED_0603
D33: VU_28; LED_0603
D34: VU_29; LED_0603
D35: VU_30; LED_0603
D36: VU_31; LED_0603
D37: ST_00; LED_0603
D38: ST_01; LED_0603
D39: ST_02; LED_0603
D40: ST_03; LED_0603
D41: ST_04; LED_0603
D42: ST_05; LED_0603
J9: Display - secondary; Hirose_FH12-16S-1_SH
J10: Display - main; Hirose_FH12-16S-1_SH
R27: 1k; R_0603
R28: 24K; R_0603
U7: MAX7219; SOIC-24W_7.5x15.4mm_Pitch1.27mm

Connections:
+5V: C49.1, C50.1, J9.15, J10.2, R27.1, R28.1, U7.19 (V+); also elsewhere on the board
/Leds/DIG_0: D5.1 (K), D6.1 (K), D7.1 (K), D8.1 (K), D9.1 (K), D10.1 (K), D11.1 (K), D12.1 (K), J9.9, J10.8, U7.2 (DIG_0)
/Leds/DIG_1: D13.1 (K), D14.1 (K), D15.1 (K), D16.1 (K), D17.1 (K), D18.1 (K), D19.1 (K), D20.1 (K), J9.10, J10.7, U7.11 (DIG_1)
/Leds/DIG_2: D21.1 (K), D22.1 (K), D23.1 (K), D24.1 (K), D25.1 (K), D26.1 (K), D27.1 (K), D28.1 (K), J9.11, J10.6, U7.6 (DIG_2)
/Leds/DIG_3: D29.1 (K), D30.1 (K), D31.1 (K), D32.1 (K), D33.1 (K), D34.1 (K), D35.1 (K), D36.1 (K), J9.12, J10.5, U7.7 (DIG_3)
/Leds/DIG_4: D37.1 (K), D38.1 (K), D39.1 (K), D40.1 (K), D41.1 (K), D42.1 (K), J9.13, J10.4, U7.3 (DIG_4)
/Leds/DIG_5: U7.10 (DIG_5)
/Leds/DIG_6: U7.5 (DIG_6)
/Leds/DIG_7: U7.8 (DIG_7)
/Leds/SEG_A: D11.2 (A), D19.2 (A), D27.2 (A), D35.2 (A), J9.7, J10.10, U7.14 (SEG_A)
/Leds/SEG_B: D10.2 (A), D18.2 (A), D26.2 (A), D34.2 (A), D42.2 (A), J9.6, J10.11, U7.16 (SEG_B)
/Leds/SEG_C: D9.2 (A), D17.2 (A), D25.2 (A), D33.2 (A), D41.2 (A), J9.5, J10.12, U7.20 (SEG_C)
/Leds/SEG_D: D8.2 (A), D16.2 (A), D24.2 (A), D32.2 (A), D40.2 (A), J9.4, J10.13, U7.23 (SEG_D)
/Leds/SEG_DP: D12.2 (A), D20.2 (A), D28.2 (A), D36.2 (A), J9.8, J10.9, U7.22 (SEG_DP)
/Leds/SEG_E: D7.2 (A), D15.2 (A), D23.2 (A), D31.2 (A), D39.2 (A), J9.3, J10.14, U7.21 (SEG_E)
/Leds/SEG_F: D6.2 (A), D14.2 (A), D22.2 (A), D30.2 (A), D38.2 (A), J9.2, J10.15, U7.15 (SEG_F)
/Leds/SEG_G: D5.2 (A), D13.2 (A), D21.2 (A), D29.2 (A), D37.2 (A), J9.1, J10.16, U7.17 (SEG_G)
CLK: U7.13 (CLK); also elsewhere on the board
DGND: C49.2, C50.2, D4.1 (K), J9.16, J9.17, J10.1, J10.17, U7.4 (GND), U7.9 (GND); also elsewhere on the board
MAX_CS: U7.12 (LOAD(~CS~)); also elsewhere on the board
MOSI: U7.1 (DIN); also elsewhere on the board
unnamed: D4.2 (A), R27.2
unnamed: R28.2, U7.18 (ISET)

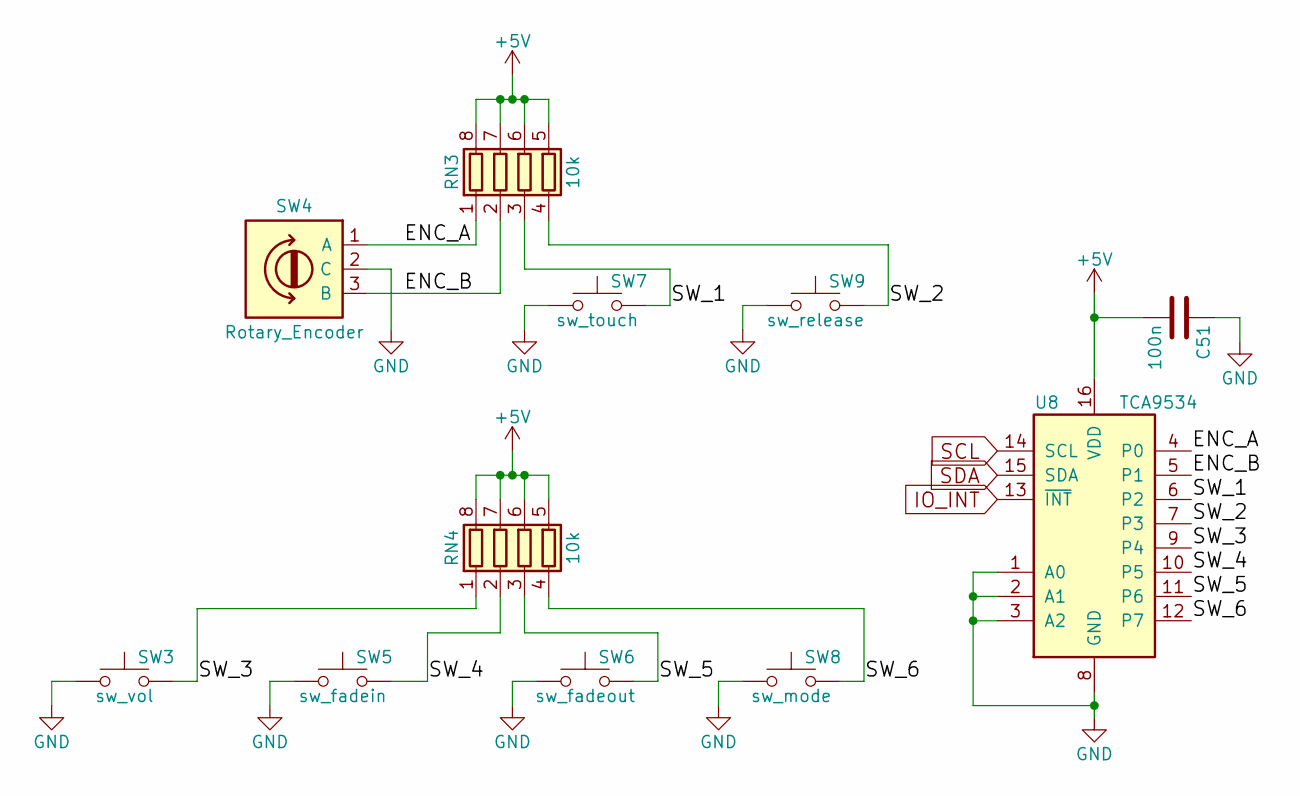
[picture p10: schematic Buttons.sch]

Parts:
C51: 100n; C_0603
RN3, RN4: 10k; R_Array_Concave_4x0603
SW3: sw_vol; SW_Tactile_SKHH_Angled
SW4: Rotary_Encoder; ALPS_EC11B_rotary_encoder
SW5: sw_fadein; SW_Tactile_SKHH_Angled
SW6: sw_fadeout; SW_Tactile_SKHH_Angled
SW7: sw_touch; SW_Tactile_SKHH_Angled
SW8: sw_mode; SW_Tactile_SKHH_Angled
SW9: sw_release; SW_Tactile_SKHH_Angled
U8: TCA9534; TSSOP-16_4.4x5mm_Pitch0.65mm

Connections:
+5V: C51.2, RN3.5 (R4.2), RN3.6 (R3.2), RN3.7 (R2.2), RN3.8 (R1.2), RN4.5 (R4.2), RN4.6 (R3.2), RN4.7 (R2.2), RN4.8 (R1.2), U8.16 (VDD); also elsewhere on the board
/Buttons/ENC_A: RN3.1 (R1.1), SW4.1 (A), U8.4 (P0)
/Buttons/ENC_B: RN3.2 (R2.1), SW4.3 (B), U8.5 (P1)
/Buttons/SW_1: RN3.3 (R3.1), SW7.2, U8.6 (P2)
/Buttons/SW_2: RN3.4 (R4.1), SW9.2, U8.7 (P3)
/Buttons/SW_3: RN4.1 (R1.1), SW3.2, U8.9 (P4)
/Buttons/SW_4: RN4.2 (R2.1), SW5.2, U8.10 (P5)
/Buttons/SW_5: RN4.3 (R3.1), SW6.2, U8.11 (P6)
/Buttons/SW_6: RN4.4 (R4.1), SW8.2, U8.12 (P7)
DGND: C51.1, SW3.1, SW4.2 (C), SW5.1, SW6.1, SW7.1, SW8.1, SW9.1, U8.1 (A0), U8.2 (A1), U8.3 (A2), U8.8 (GND); also elsewhere on the board
IO_INT: U8.13 (~INT~); also elsewhere on the board
SCL: U8.14 (SCL); also elsewhere on the board
SDA: U8.15 (SDA); also elsewhere on the board

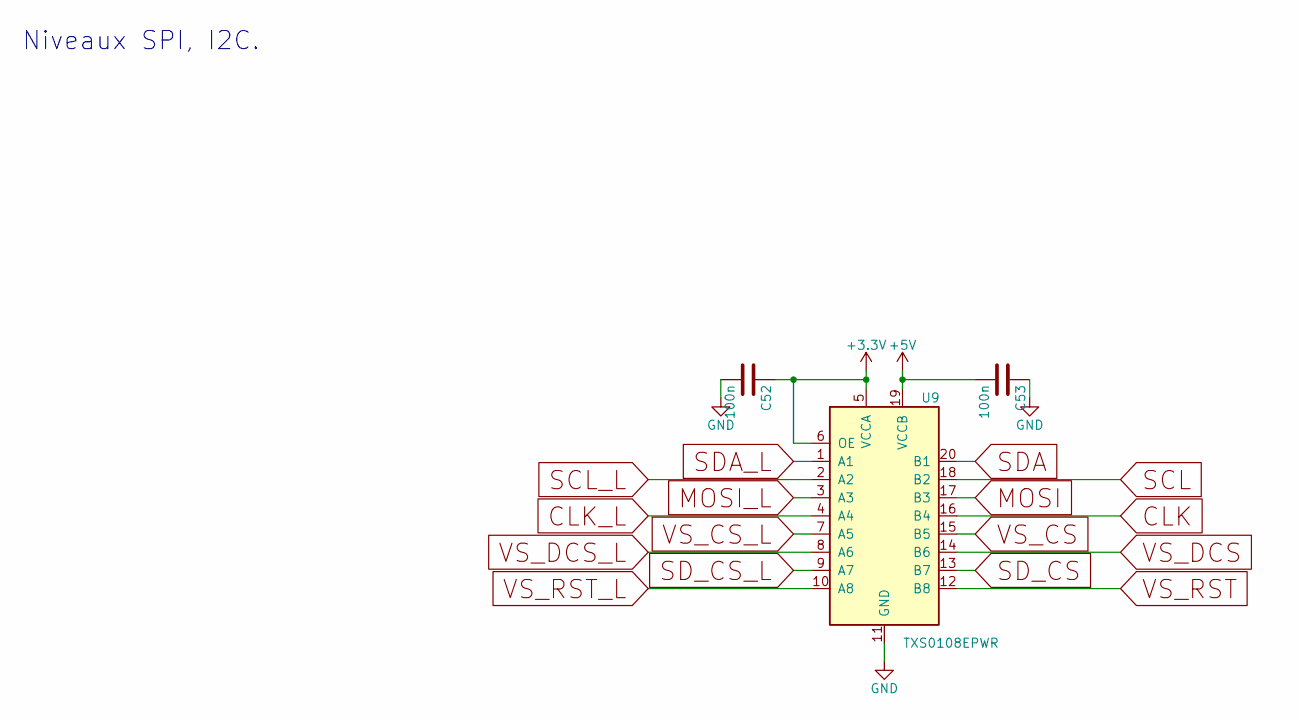
[picture p11: schematic Conversion.sch]

Parts:
C52, C53: 100n; C_0603
U9: TXS0108EPWR; TSSOP-20_4.4x6.5mm_Pitch0.65mm

Connections:
+5V: C53.2, U9.19 (VCCB); also elsewhere on the board
CLK: U9.16 (B4); also elsewhere on the board
CLK_L: U9.4 (A4); also elsewhere on the board
DGND: C52.2, C53.1, U9.11 (GND); also elsewhere on the board
MOSI: U9.17 (B3); also elsewhere on the board
MOSI_L: U9.3 (A3); also elsewhere on the board
SCL: U9.18 (B2); also elsewhere on the board
SCL_L: U9.2 (A2); also elsewhere on the board
SDA: U9.20 (B1); also elsewhere on the board
SDA_L: U9.1 (A1); also elsewhere on the board
SD_CS: U9.13 (B7); also elsewhere on the board
SD_CS_L: U9.9 (A7); also elsewhere on the board
VS_CS: U9.15 (B5); also elsewhere on the board
VS_CS_L: U9.7 (A5); also elsewhere on the board
VS_DCS: U9.14 (B6); also elsewhere on the board
VS_DCS_L: U9.8 (A6); also elsewhere on the board
VS_RST: U9.12 (B8); also elsewhere on the board
VS_RST_L: U9.10 (A8); also elsewhere on the board

Notes on the sheet:
Niveaux SPI, I2C.

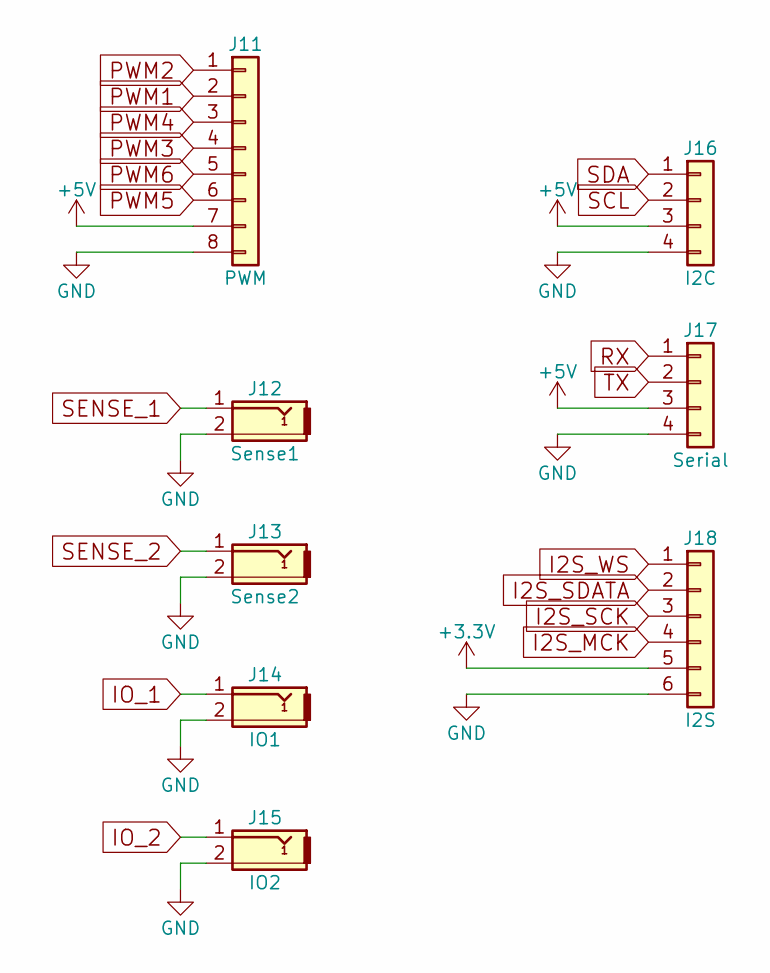
[picture p12: schematic Connexions.sch]

Parts:
J11: PWM; Pin_Header_Straight_1x08_Pitch2.54mm
J12: Sense1; PJ320D_3.5mm_Jack
J13: Sense2; PJ320D_3.5mm_Jack
J14: IO1; PJ320D_3.5mm_Jack
J15: IO2; PJ320D_3.5mm_Jack
J16: I2C; Pin_Header_Straight_1x04_Pitch2.54mm
J17: Serial; Pin_Header_Straight_1x04_Pitch2.54mm
J18: I2S; Pin_Header_Straight_1x06_Pitch2.54mm

Connections:
+5V: J11.7, J16.3, J17.3; also elsewhere on the board
DGND: J11.8, J12.2, J12.3, J12.4, J13.2, J13.3, J13.4, J14.2, J14.3, J14.4, J15.2, J15.3, J15.4, J16.4, J17.4, J18.6; also elsewhere on the board
I2S_MCK: J18.4; also elsewhere on the board
I2S_SCK: J18.3; also elsewhere on the board
I2S_SDATA: J18.2; also elsewhere on the board
I2S_WS: J18.1; also elsewhere on the board
IO_1: J14.1; also elsewhere on the board
IO_2: J15.1; also elsewhere on the board
PWM1: J11.2; also elsewhere on the board
PWM2: J11.1; also elsewhere on the board
PWM3: J11.4; also elsewhere on the board
PWM4: J11.3; also elsewhere on the board
PWM5: J11.6; also elsewhere on the board
PWM6: J11.5; also elsewhere on the board
RX: J17.1; also elsewhere on the board
SCL: J16.2; also elsewhere on the board
SDA: J16.1; also elsewhere on the board
SENSE_1: J12.1; also elsewhere on the board
SENSE_2: J13.1; also elsewhere on the board
TX: J17.2; also elsewhere on the board

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
