troisiemetype/ccboard/ContactConsequencesMono.kicad_pcb

## KiCad design ContactConsequencesMono.kicad_pcb (continued)

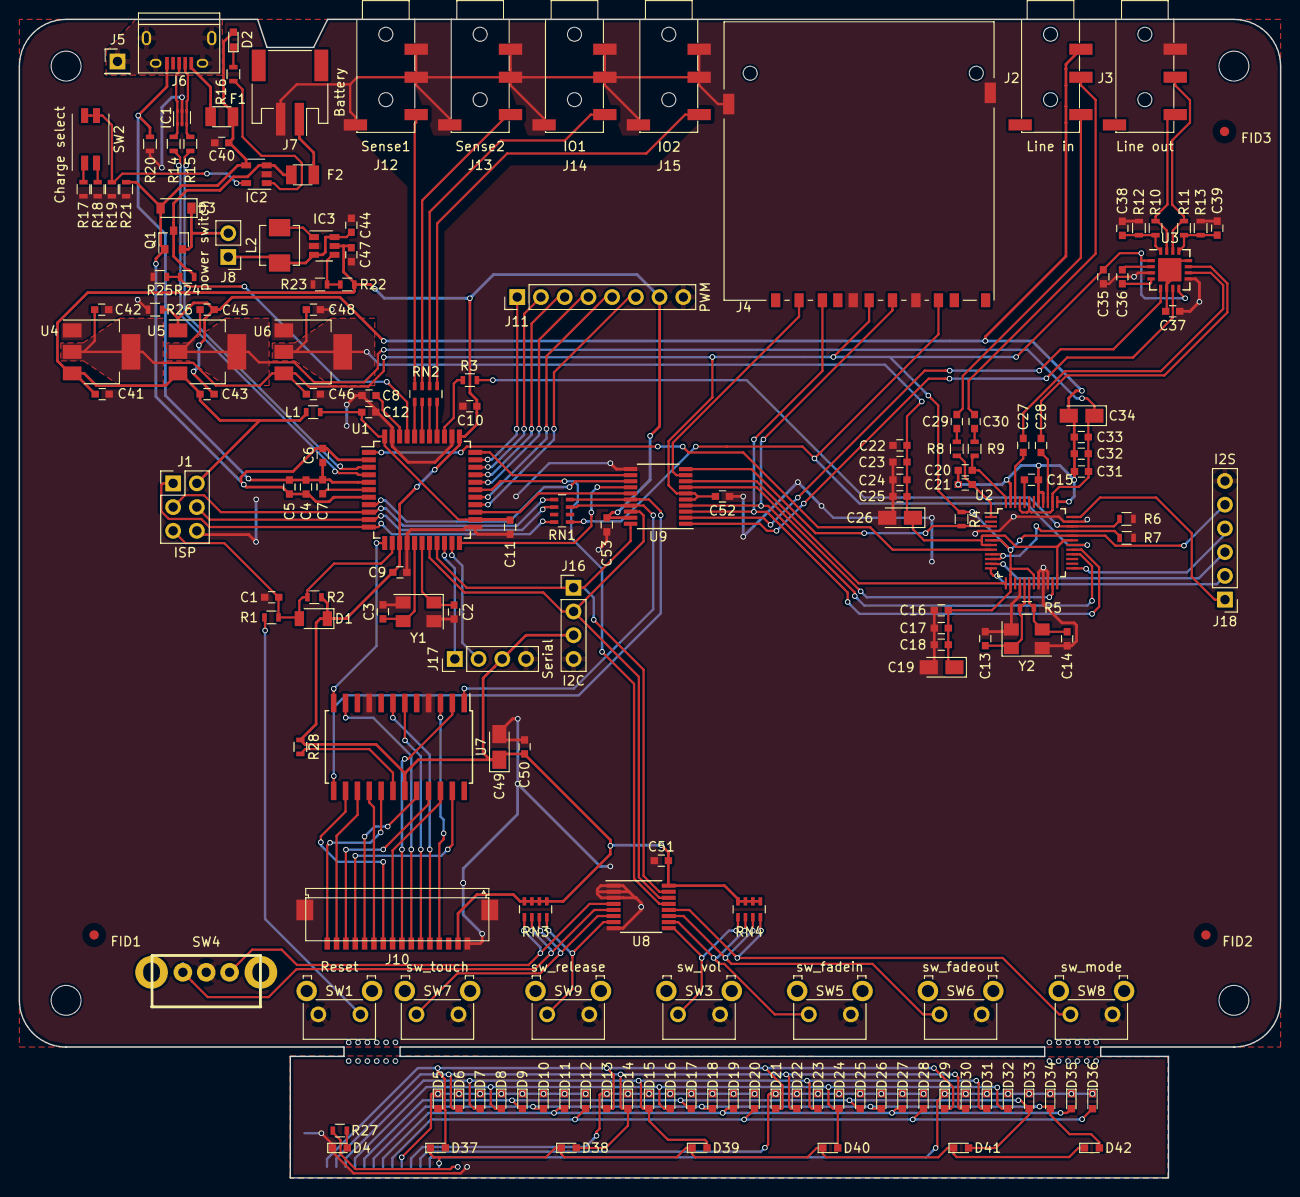
[picture p13: board ContactConsequencesMono.kicad_pcb from above]

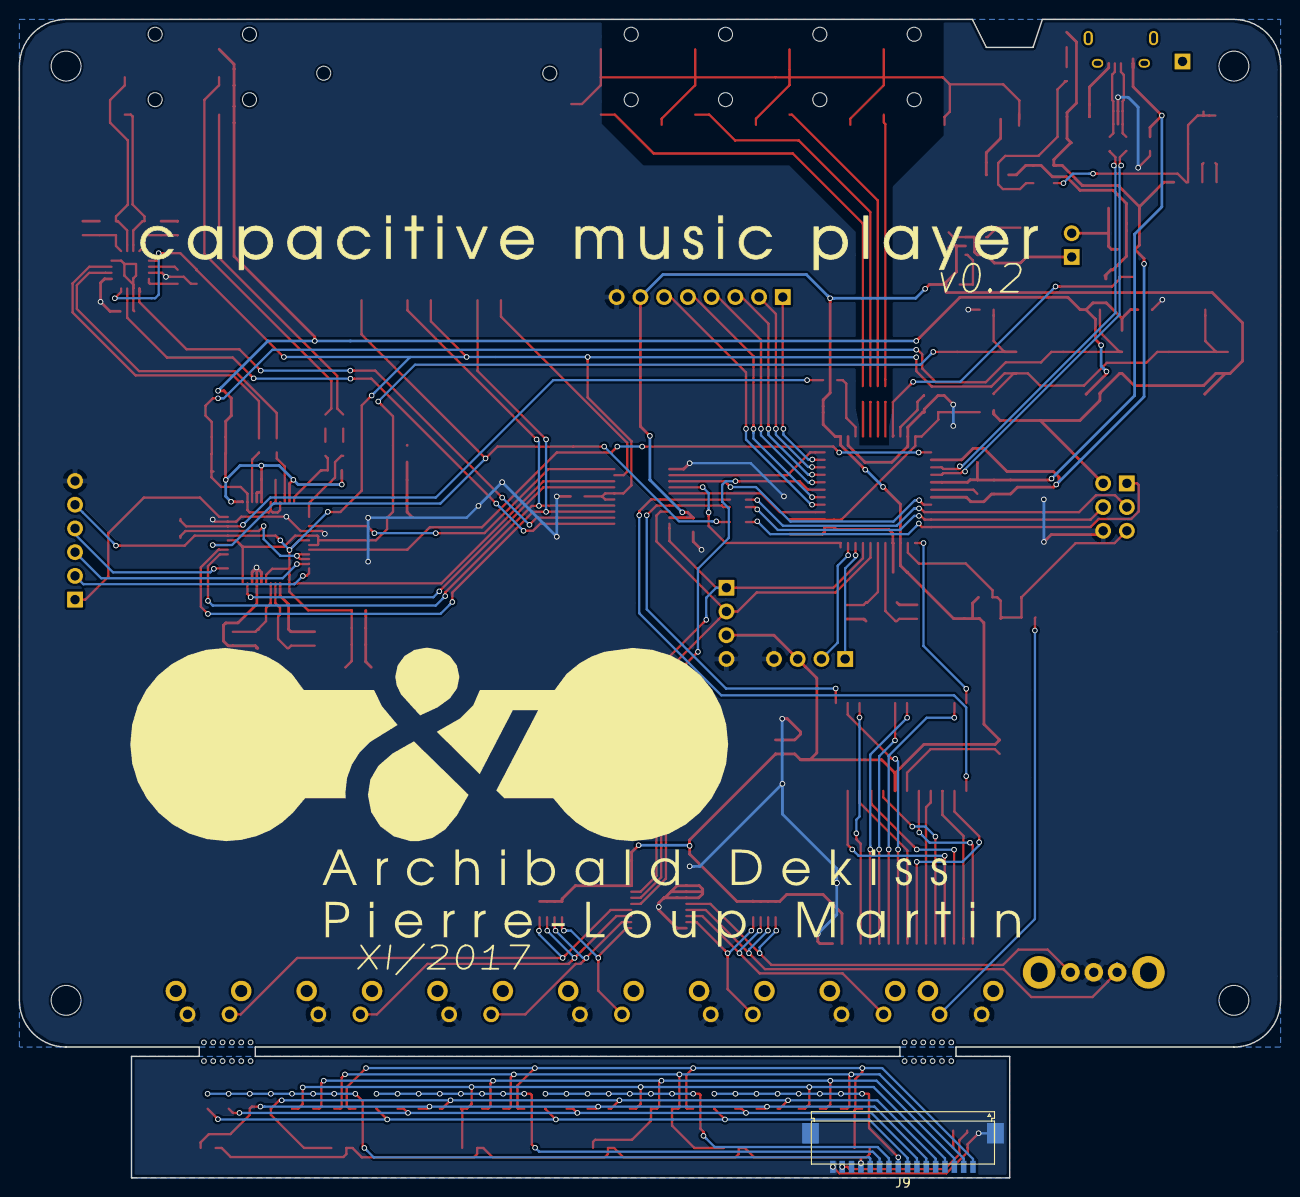
[picture p14: board ContactConsequencesMono.kicad_pcb from below]

Board: 2 copper layers, 135.0 x 124.0 mm, 187 parts (4 on the bottom side), 122 nets.

Other parts of the board:
svg2mod: G***; cc_Silk_60mm
svg2mod#2: G***; cc_noms
svg2mod#3: G***; cc_capacitivemusicplayer
