troisiemetype/ccboard/(commit log)

2017-09-26 Initial commit.
    [Arduino.sch, Audio.sch, Button.sch, Buttons.sch, Connexions.sch, ContactConsequencesMono.kicad_pcb, ContactConsequencesMono.sch, Conversion.sch]
2017-09-27 Board should be ok. Bargraph leds yet to do.
    [Arduino.sch, Audio.sch, Buttons.sch, Connexions.sch, ContactConsequencesMono.kicad_pcb, Leds.sch, Power.sch, USB.sch]
2017-09-28 Seems to be good for fabrication launch. Probably minor things to fix.
    [Buttons.sch, Connexions.sch, ContactConsequencesMono.kicad_pcb, Conversion.sch, Leds.sch]
2017-11-01 Board modified after ckecking. Ready for fab, just need to create gerber, position and components files.
    [Arduino.sch, Audio.sch, Buttons.sch, Connexions.sch, ContactConsequencesMono.kicad_pcb, ContactConsequencesMono.sch, Conversion.sch, Leds.sch]
2017-11-02 v0.1 ok for fab. Quote asked to PCB maker.
    [BOM.csv, BOM.ods, ContactConsequencesMono - components before checking.ods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]
2017-11-03 Updated project with connector for main power switch. Modified fabrication files.
    [BOM.csv, BOM.ods, BOM.xlsx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]
2017-11-15 v0.2 ready for fabrication. Voltage regulators replaced by cheaper ones.
    [BOM.csv, BOM.ods, BOM.xlsx, Buttons.sch, Connexions.sch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]
